CrazyHao1514/osd/1-5-OSD_Ⅰ_V3屏幕驱动及资料/pin脚图.jpg

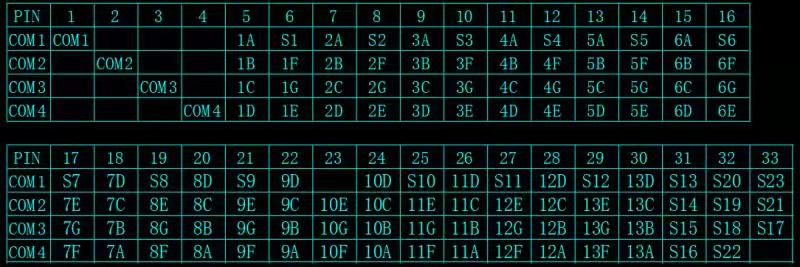
1-5-OSD_Ⅰ_V3屏幕驱动及资料/pin脚图.jpg
