CrazyHao1514/osd/文书/content.md

# 绪论
## 背景和意义
## 国内外发展现状
## 本文主要内容
# 环境监测系统设计
## 温度采集原理
## K型热电偶分析
## 环境监测系统设计框图
# 系统的硬件设计
## 温度传感器选择
## 信号调理模块设计
## A/D采样模块设计
## 核心处理器设计
## 电源转换模块选择
## 通信模块设计
## PCB抗干扰电路
# 系统的软件设计
## 自定义通信协议
## 下位机设计
## 上位机设计
# 测试与分析
## 硬件测试
## 软件测试
# 总结与展望
