CrazyHao1514/osd/3-1-OSD_I_V3 PCB图纸/华秋_1-2-OSD_Ⅰ_V3PCB设计图纸.pdf

auditwidget [Top Paste] Ratio:92.71% 周三 8月 14 12:19:01 2024 层数：4 尺寸：95.50*76.00 mm

a

u

ditwid
g

et [T
o

p

Silk] R
atio:9
2.71%

周
三

8

月 14 12:19:01 2
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
auditwidget [Top Solder] Ratio:92.71% 周三 8月 14 12:19:01 2024 auditwidget [Top Copper] Ratio:92.71% 周三 8月 14 12:19:01 2024

a

u

ditwid
g

et [In
n

er2] R

atio:9
2.71%

周
三

8

月 14 12:19:01 2
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
auditwidget [Inner3] Ratio:92.71% 周三 8月 14 12:19:02 2024 auditwidget [Bot Copper] Ratio:92.71% 周三 8月 14 12:19:02 2024 auditwidget [Bot Solder] Ratio:92.71% 周三 8月 14 12:19:02 2024

a

u

ditwid
g

et [B

ot Silk] R
atio:9
2.71%

周
三

8

月 14 12:19:0
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
auditwidget [Bot Paste] Ratio:92.71% 周三 8月 14 12:19:02 2024 auditwidget [Drl] Ratio:92.71% 周三 8月 14 12:19:02 2024 auditwidget [Outline] Ratio:92.71% 周三 8月 14 12:19:02 2024

a

u

ditwid
g

et [Drl Dra
w] R

atio:9
2.71%

周
三

8

月 14 12:19:0
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
auditwidget [2DLine.pho] Ratio:92.71% 周三 8月 14 12:19:02 2024
