CrazyHao1514/osd/文书/theory.md

# 基于NB-IoT的环境监测系统设计
# 1绪论
## 1.1背景和意义
21世纪，伴随医疗技术的突飞猛进，疾病治疗的空间尺度也在不断地缩小。当治疗技术深入到人体最基本的单位——细胞的层面时，便可以从根源上为患者解除病痛，达成更为彻底的治疗效果，因此细胞治疗成为了异于传统药物治疗和手术治疗的新热点。细胞治疗，指将（深）低温保存的人体健康细胞通过移植或是静脉注射的方式实现更新，进而促进人体重建组织的这一种治疗方法。这一技术的出现，为恶性肿瘤、原发性高血压、阿尔兹海默症等多种难以治愈的疾病提供了新的技术可能。

细胞存储作为细胞治疗技术产业链的上游基础，其供给的细胞质量高低，关系细胞治疗技术的发展。目前，广泛使用的生物细胞保存技术是超低温细胞冷冻存储技术。它是在低温（77K）条件下，通过抑制细胞生命活动，从而达到长期存储的目的，并且在解冻后仍能使得细胞保持生理活性的一种技术。

低温具有两面性，它既可以让生物样品处于低代谢状态，长期存储并保持活性，又能够在保存的过程中损伤细胞。在低温保存的过程中，样品的损伤主要来源自溶质损伤和机械损伤：
1) 溶质损伤。溶质损伤是由于温度曲线下降过慢导致的，此时水发生凝固，胞间游离的金属离子浓度突变增大；对于蛋白质等生物大分子而言，空间结构可能会被破坏，造成变性，引发功能不可逆损伤。
2) 机械损伤。机械损伤通常由冰晶生长的机械力引起。冰晶在细胞内和溶质中均存在，并且冰晶的体积与细胞存活率呈负相关。

上述两种冷冻损伤与温度梯度变化率关系密切，冰晶的形成和溶质浓度的改变亦受降温速度影响，是优化（深）低温保存的重要方向。
## 1.2国内外发展现状
### 1.2.1自动化样本库系统
国际上在近十几年内开展了一系列生物样本低温环境自动化存储的的研究和实践。以Biolix STC(Li CONi C,列支敦士登)193K自动化智能存储系统为例,其展示了自动化样本库系统的基本架构,组成的硬件包括热交换区、输送机械臂、程控降温仪(冰箱或液氮罐),均接受样本管理软件传达的指令。
### 1.2.2玻璃化保存技术
对于RNA、组织等珍贵样品，玻璃化保存则更为普遍，这要求环境温度低于137K；玻璃化保存时生化反应都趋近于停止。上海理工大学已经在生物样本的深低温存储方面积累了雄厚的理论基础，主要包括：置核-程序降温热控制方法，低温保护剂的热物性，生物体低温保存过程热分析。
## 1.3目前存在的问题
1) 现有玻璃化保存技术逐渐普及，但大多数程控降温设备的温度监测范围仍局限在223K至193K之间，无法覆盖玻璃化保存所需的137K以下的温度范围。
2) 市场上出现了以机械臂为核心的自动化样本处理设备，极大地降低了操作人员发生冻伤的风险。然而，目前多数此类设备依赖进口，采购成本高昂。
3) 虽然现有的样本库系统具备与计算机的通信功能，但数据主要在本地进行处理和存储，不利于样本信息的共享，也缺乏便捷的远程报警机制。
## 1.4本课题主要工作
本课题针对当前生物样本库在温度监测领域的现状，提出了一种基于窄带物联网（NB-IoT）的温度监测系统，旨在提升深低温保存技术的应用效果及系统的整体智能化水平。具体内容如下：
1) 应用温度检测范围下限低于137K的温度传感器，适配玻璃化保存技术。
2) 提供多种常见通信接口，以提高系统的兼容性和扩展性，避免样本中心重新采购昂贵设备的必要。
3) 引入窄带物联网技术和云数据托管平台，实现对温度异常等事件的主动上报，并支持通过短信推送提醒功能。
# 2系统方案设计
## 2.1温度采集原理
在计算机发明之前，人类主要依赖度量衡工具和自身感官来获取被测物体的各类信息，随后使用纸笔记录数据。然而，随着科学研究的深入以及工业生产需求的增加，数据处理的复杂性和精确度要求逐渐提高，传统的手动数据采集和记录方式显然已无法满足这些需求。

为了克服传统数据采集和记录方法的局限性，计算机和传感器应运而生。计算机作为一种用于高速运算的电子设备，能够自动化地处理大量数据，从而显著提升了人类的计算能力。然而，计算机只能处理二进制形式的电信号，而现实中大多数信号为非电量信号。因此，如果仍采用人工方式将这些信号输入计算机，数据处理的效率将大大降低。这就需要引入传感器技术。传感器是一种检测装置，能够感知被测物体的物理量信息，并将这些信息按照特定规律转换成电信号或其他所需形式（如频率或脉冲信号）。通过传感器，非电量信号被转换为电信号，再经过模数转换器将这些电信号（模拟信号）转换为数字信号（如二进制数），从而实现与计算机的有效连接与数据处理。

温度传感器是传感器技术中的重要组成部分，主要分为接触式和非接触式两大类。接触式温度传感器包括热电偶和热敏电阻，这些传感器需与被测物体直接接触；而非接触式温度传感器则通过检测物体所产生的热辐射来测量温度。
1) 热电偶是一种基于塞贝克效应的温度传感器，利用两种不同金属在接合点处的温差产生电压来测量温度。1821年，德国科学家塞贝克发现，当两种不同金属连接成回路，并在两端接点处施加不同温度时，回路中会产生电流，称为热电流，而产生的电势则称为热电势。热电偶由两个不同的导体或半导体材料构成闭合回路，当两接点（测量端与冷端）存在温差时，回路中产生的热电势与温差成正比。通过测量热电势，可以确定测量端的温度。
2) 热敏电阻
热敏电阻由半导体材料构成，其电阻率对温度变化极为敏感。根据电阻率随温度变化的不同特性，热敏电阻可分为正温度系数（PTC）热敏电阻和负温度系数（NTC）热敏电阻。PTC热敏电阻的电阻值会随温度升高而增加；相反，NTC热敏电阻的电阻值会随温度升高而降低。热敏电阻的特性常用Steinhart-Hart方程来表征，该方程将热敏电阻的电阻值转换为开尔文温度值。
3) 电阻式温度检测器（RTD）
电阻式温度检测器（RTD）是一种基于金属电阻随温度变化而改变的特性来测量温度的传感器。RTD的工作原理是利用导体或半导体的热阻效应，即电阻值随温度变化而变化，通过测量其电阻值来推算温度。常用的RTD材料为铂（如Pt100），因其具有优良的稳定性和易于获取的优点。
4) 红外线温度传感器
红外线温度传感器（或称辐射温度计）的原理是通过透镜将物体发射的0.7 µm至20 µm波长的红外线聚焦到热电堆检测元件上。热电堆是一种能够吸收红外线并产生与温度相对应电信号的检测元件。该电信号经过放大和发射率补偿后，显示物体的温度。
## 2.2热电偶分析
塞贝克效应表明，由两种导体A和B再两端焊接构成的闭合回路，当其两接点保持某一温度差时，回路中将有电流流过。此回路称为热电回路，其中出现的电流称为热电流。在热电回路中存在一种电动势，称为热电动势$E_{AB}$，通常称为温差电动势。回路中的热电源$I$的大小决定于热电动势和回路中的电阻。

现在将回路断开，如图所示，图中导体A、B分别称为热电极A和热电极B。我们假设用$E_A$和电阻$R_A$来代表热电极A，用$E_B$和$R_B$来代表热电极B。如图就是用电位差计测量$V_{ab}$的等效电路。当达到平衡时$I=0$,此时有
$$\Delta V=E_{ab}=E_B-E_A \tag{1}$$
$(1)$式表明，用电位差计测得的电压降$\Delta V_{ab}$就是热电回路$(AB)$中的热电动势$E_{AB}$。由$(1)$式可知，此时热电回路中的热电动势$E_{AB}$与回路中电阻无关，仅与热电回路两接点间的温度差$\Delta T=T_2-T_1$有关。定义$\Delta V_{ab}$对$\Delta T$的微分热电动势为热电回路的热电势率，用$S_{AB}$表示，有
$$S_{AB}=\lim_{\Delta T \to 0}\frac{\Delta V_{ab}}{\Delta T}=\frac{dV_{ab}}{dT} \tag{2}$$
$S_{AB}$也称为塞贝克系数，从$(2)$式可以看出它代表该热电回路的灵敏度。考虑到$(1)$式，$(2)$式也可以写为
$$S_{AB}=\lim_{\Delta T \to 0}\frac{E_B}{\Delta T}-\lim_{\Delta T \to 0}\frac{E_A}{\Delta T}=S_B-S_A \tag{3}$$
式中$S_A$和$S_B$分别为热电极A、B的绝对热电势率。可见，某热电回路$(AB)$的塞贝克系数$S_{AB}$的正负和大小仅决定于构成此热电回路的两个热电极的绝对热电势差之差。

如果某热电回路的$S_{AB}$是已知的，则该回路的热电动势$E_{AB}$可由$(2)$式积分求得：
$$E_{AB}=\int_{T_0}^T{S_{AB}(T)}{\rm d}T \tag{4}$$
考虑到$(3)$式，上式又可表为
$$E_{AB}=\int_{T_0}^T[S_B(T)-S_A(T)]{\rm d}T \tag{5}$$
如果在有限温度范围内$(S_B-S_A)$基本恒定不变，则$(5)$式可表示为
$$E_{AB}=(S_B-S_A)\Delta T \tag{6}$$
式中$\Delta T=T_2-T_1$，表示热电回路两接点间的温度差。在实践中要应用$(6)$式来求某热电回路的热电动势值，必须假设两种热电极才是A、B的热电性是均匀的，两种热电极材料的绝对热电势差之差$(S_B-S_A)$与温度无关。这样，如果将热电回路中的一个接点保持在某一个恒定不变的温度（例如冰点）$T_0$时，则$E_{AB}$便仅随另一个接点的温度$T$而变化。也就是说，此时$E_{AB}$仅仅是温度$T$的单值函数。这样，我们可以利用这种$E_{AB}$与$T$的一一对应的关系来测量温度。

不同金属配对就构成不同的热电偶。每种热电偶的$E-T$特性常用表格、曲线的关系表示。在实验室中精确测定热电偶的$E-T$特性的程序称为分度，由此而得到的$E-T$对用表称为该种热电偶的分度表。

热电偶的两个热电极在测量端相互连接，在参考端分别与铜导线连接，铜导线的另一端分别与电测仪表的正、负接线柱连接。如图所示的就是热电偶测温的基本热电回路。
## 2.3环境监测系统设计框图
# 3系统的硬件设计
## 3.1温度传感器选择
## 3.2信号调理模块设计
## 3.3A/D采样模块设计
## 3.4核心处理器设计
## 3.5电源转换模块选择
## 3.6通信模块设计
## 3.7PCB抗干扰电路
# 4系统的软件设计
## 4.1自定义通信协议
## 4.2下位机设计
## 4.3上位机设计
# 5测试与分析
## 5.1硬件测试
## 5.2软件测试
# 6总结与展望
