CrazyHao1514/osd/文书/intro.md

# 基于NB-IoT的环境监测系统设计
# 1绪论
## 1.1背景和意义
21世纪，伴随医疗技术的突飞猛进，疾病治疗的空间尺度也在不断地缩小。当治疗技术深入到人体最基本的单位——细胞的层面时，便可以从根源上为患者解除病痛，达成更为彻底的治疗效果，因此细胞治疗成为了异于传统药物治疗和手术治疗的新热点。细胞治疗，指将（深）低温保存的人体健康细胞通过移植或是静脉注射的方式实现更新，进而促进人体重建组织的这一种治疗方法。这一技术的出现，为恶性肿瘤、原发性高血压、阿尔兹海默症等多种难以治愈的疾病提供了新的技术可能。

细胞存储作为细胞治疗技术产业链的上游基础，其供给的细胞质量高低，关系细胞治疗技术的发展。目前，广泛使用的生物细胞保存技术是超低温细胞冷冻存储技术。它是在低温（77K）条件下，通过抑制细胞生命活动，从而达到长期存储的目的，并且在解冻后仍能使得细胞保持生理活性的一种技术。

低温具有两面性，它既可以让生物样品处于低代谢状态，长期存储并保持活性，又能够在保存的过程中损伤细胞。在低温保存的过程中，样品的损伤主要来源自溶质损伤和机械损伤： <br/>
1) 溶质损伤。溶质损伤是由于温度曲线下降过慢导致的，此时水发生凝固，胞间游离的金属离子浓度突变增大；对于蛋白质等生物大分子而言，空间结构可能会被破坏，造成变性，引发功能不可逆损伤。<br/>
2) 机械损伤。机械损伤通常由冰晶生长的机械力引起。冰晶在细胞内和溶质中均存在，并且冰晶的体积与细胞存活率呈负相关。

上述两种冷冻损伤与温度梯度变化率关系密切，冰晶的形成和溶质浓度的改变亦受降温速度影响，是优化（深）低温保存的重要方向。
## 1.2国内外发展现状
### 1.2.1自动化样本库系统
国际上在近十几年内开展了一系列生物样本低温环境自动化存储的的研究和实践。以Biolix STC(Li CONi C,列支敦士登)193K自动化智能存储系统为例,其展示了自动化样本库系统的基本架构,组成的硬件包括热交换区、输送机械臂、程控降温仪(冰箱或液氮罐),均接受样本管理软件传达的指令。
### 1.2.2玻璃化保存技术
对于RNA、组织等珍贵样品，玻璃化保存则更为普遍，这要求环境温度低于137K；玻璃化保存时生化反应都趋近于停止。上海理工大学已经在生物样本的深低温存储方面积累了雄厚的理论基础，主要包括：置核-程序降温热控制方法，低温保护剂的热物性，生物体低温保存过程热分析。
## 1.3本课题主要工作
本课题针对当前生物样本库在温度监测领域的现状，提出了一种基于窄带物联网（NB-IoT）的温度监测系统，旨在提升深低温保存技术的应用效果及系统的整体智能化水平。具体内容如下：
1) 首先，现有玻璃化保存技术逐渐普及，但大多数程控降温设备的温度监测范围仍局限在-50至-80摄氏度之间，无法覆盖玻璃化保存所需的-136摄氏度以下的温度范围。为此，本文选用K型热电偶作为温度传感器，其低温探测能力优于传统设备，能够满足更为严苛的深低温保存需求。
2) 其次，随着自动化技术在生物工程领域的融合发展，市场上出现了以机械臂为核心的自动化样本处理设备，极大地降低了操作人员发生冻伤的风险。然而，目前多数此类设备依赖进口，采购成本高昂。本文设计的系统同时提供了USART和RS485两种常见通信接口，以提高系统的兼容性和扩展性，避免重新采购昂贵设备的必要。
3) 最后，虽然现有的样本库系统具备与计算机的通信功能，但数据主要在本地进行处理和存储，不利于样本信息的共享，也缺乏便捷的远程报警机制。本文引入窄带物联网技术和云数据托管平台，实现对温度异常等事件的主动上报，并支持通过短信推送提醒功能，降低了系统使用者的技术门槛，提升了系统的易用性和安全性。
# 2环境监测系统设计
## 2.1温度采集原理
## 2.2K型热电偶分析
## 2.3环境监测系统设计框图
# 3系统的硬件设计
## 3.1温度传感器选择
## 3.2信号调理模块设计
## 3.3A/D采样模块设计
## 3.4核心处理器设计
## 3.5电源转换模块选择
## 3.6通信模块设计
## 3.7PCB抗干扰电路
# 4系统的软件设计
## 4.1自定义通信协议
## 4.2下位机设计
## 4.3上位机设计
# 5测试与分析
## 5.1硬件测试
## 5.2软件测试
# 6总结与展望
