CrazyHao1514/osd/IMG/2108.jpg

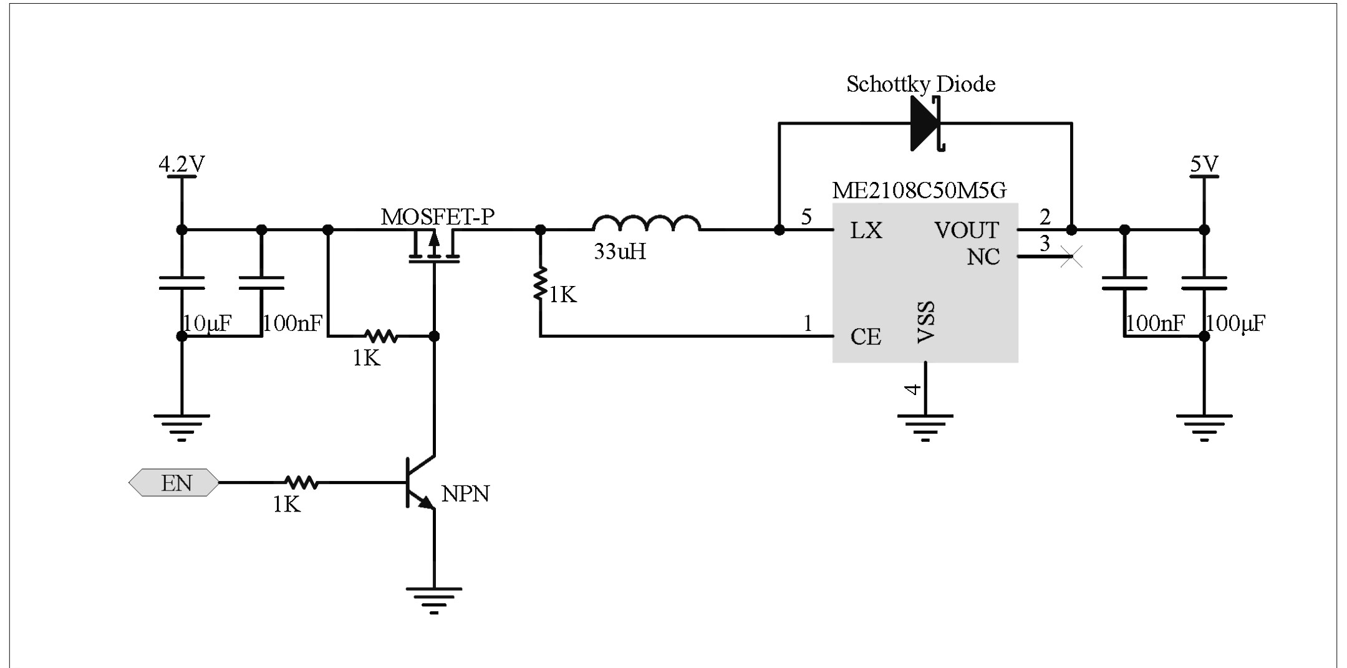
IMG/2108.jpg
