CrazyHao1514/osd/IMG/3085.jpg

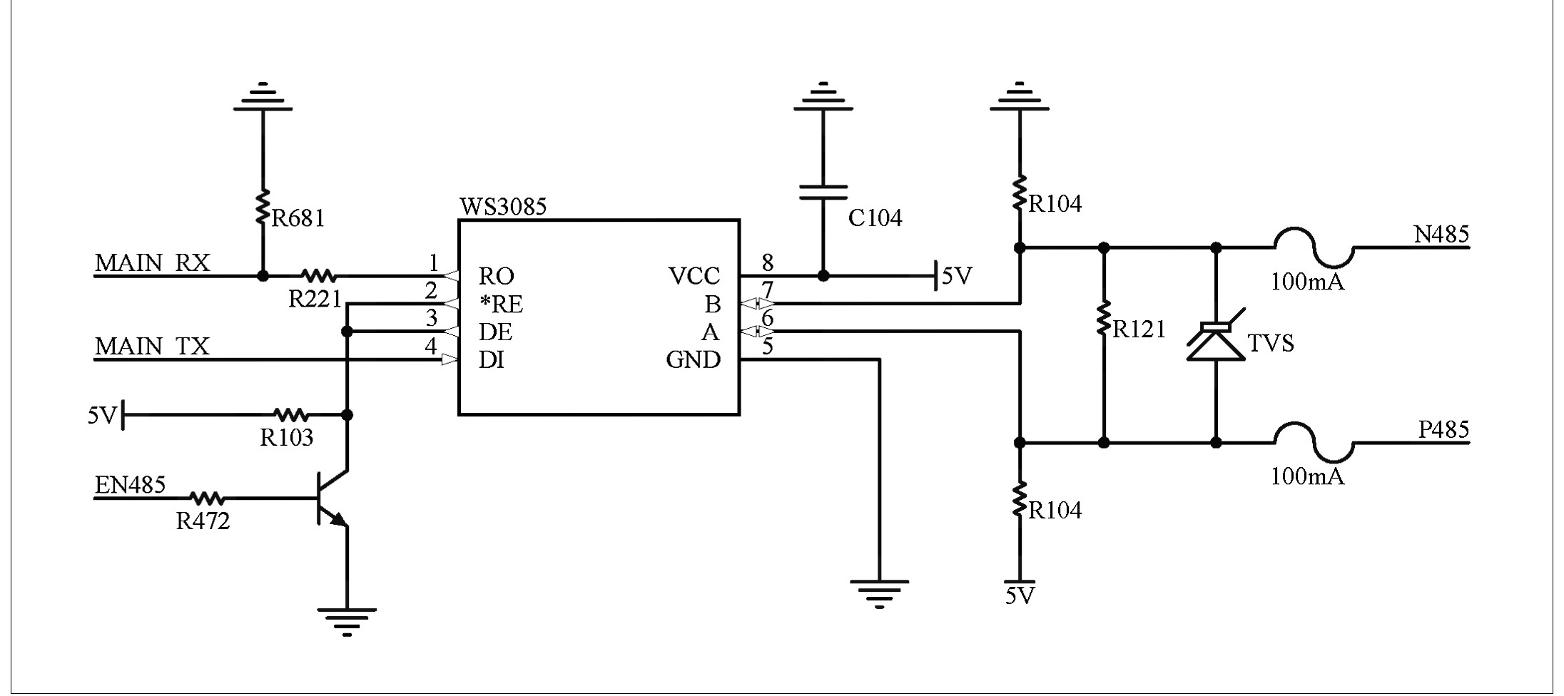
IMG/3085.jpg
