CrazyHao1514/osd/IMG/4054.jpg

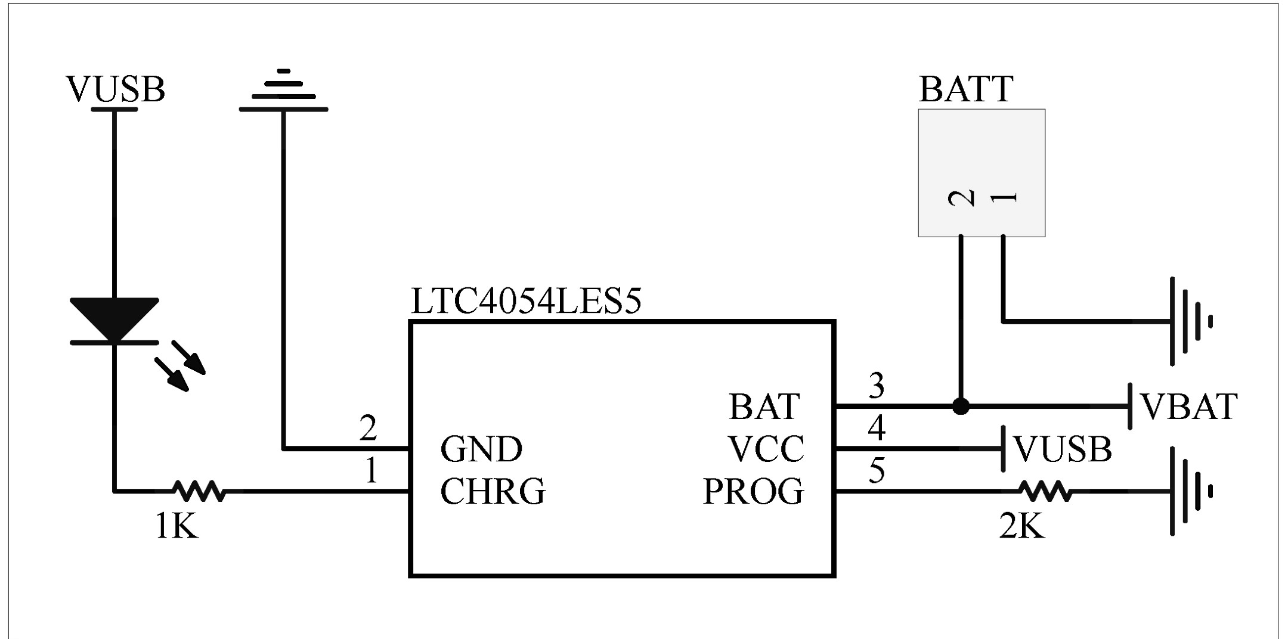
IMG/4054.jpg
