CrazyHao1514/osd/IMG/6220.jpg

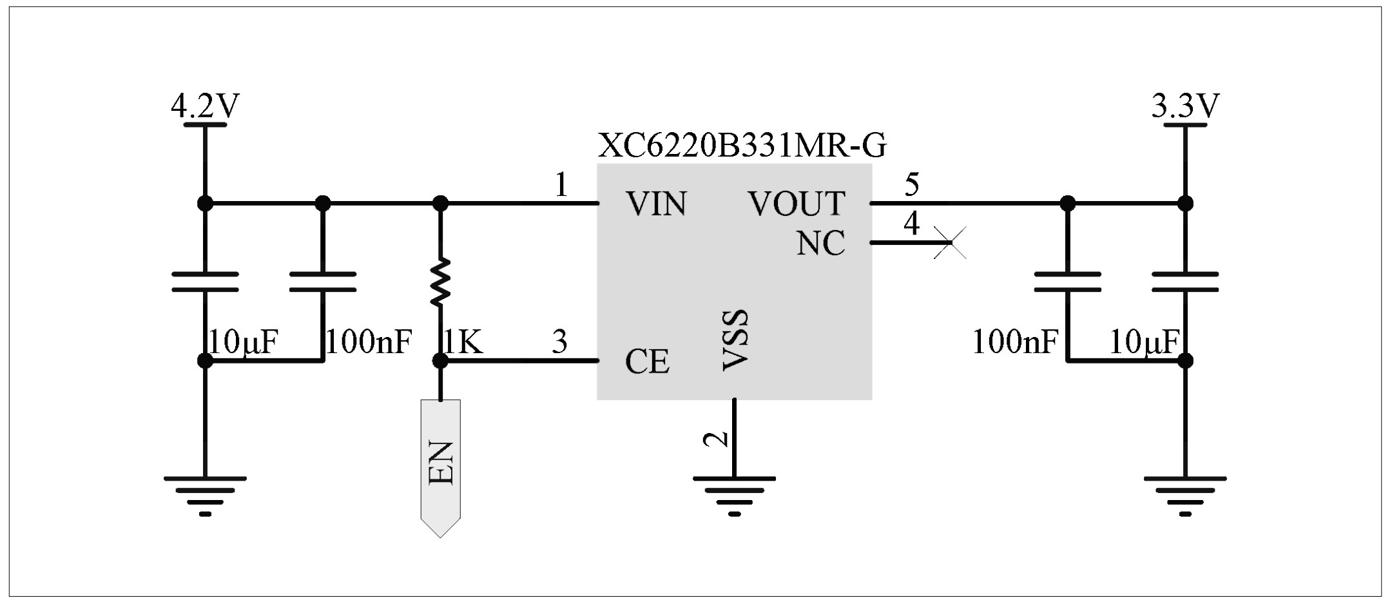
IMG/6220.jpg
