CrazyHao1514/osd/IMG/6220_CL.jpg

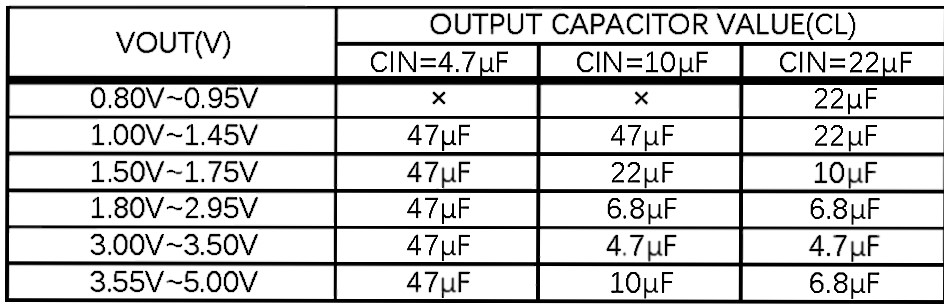
IMG/6220_CL.jpg
