CrazyHao1514/osd/IMG/29302.png

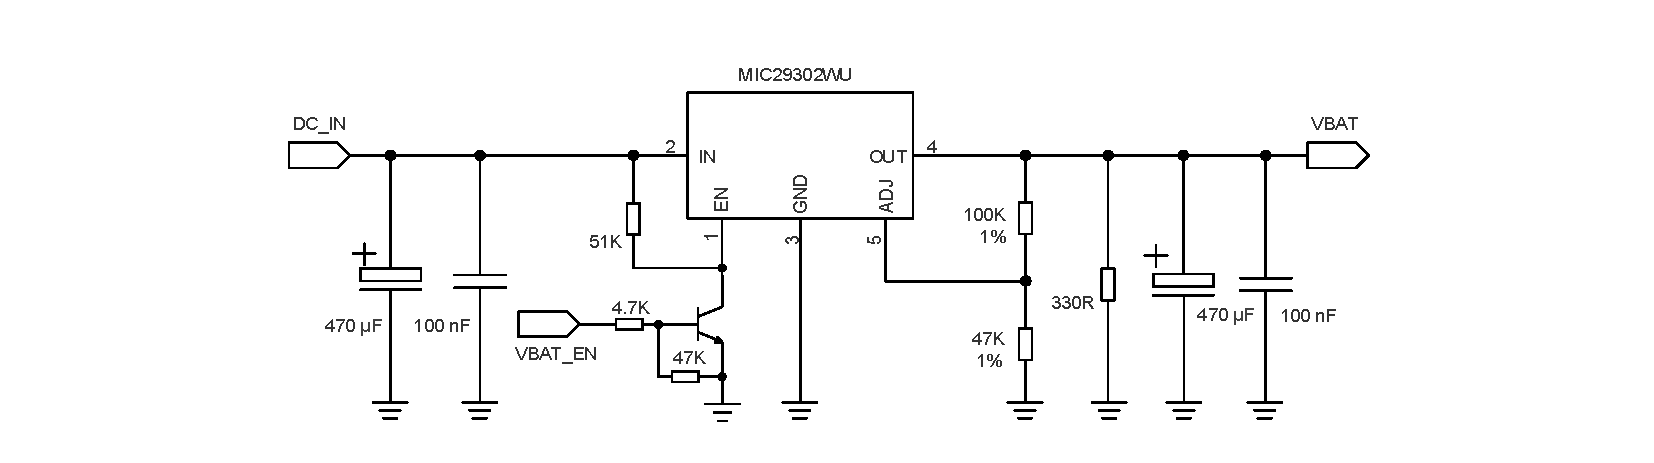
IMG/29302.png
