CrazyHao1514/osd/IMG/adc.jpg

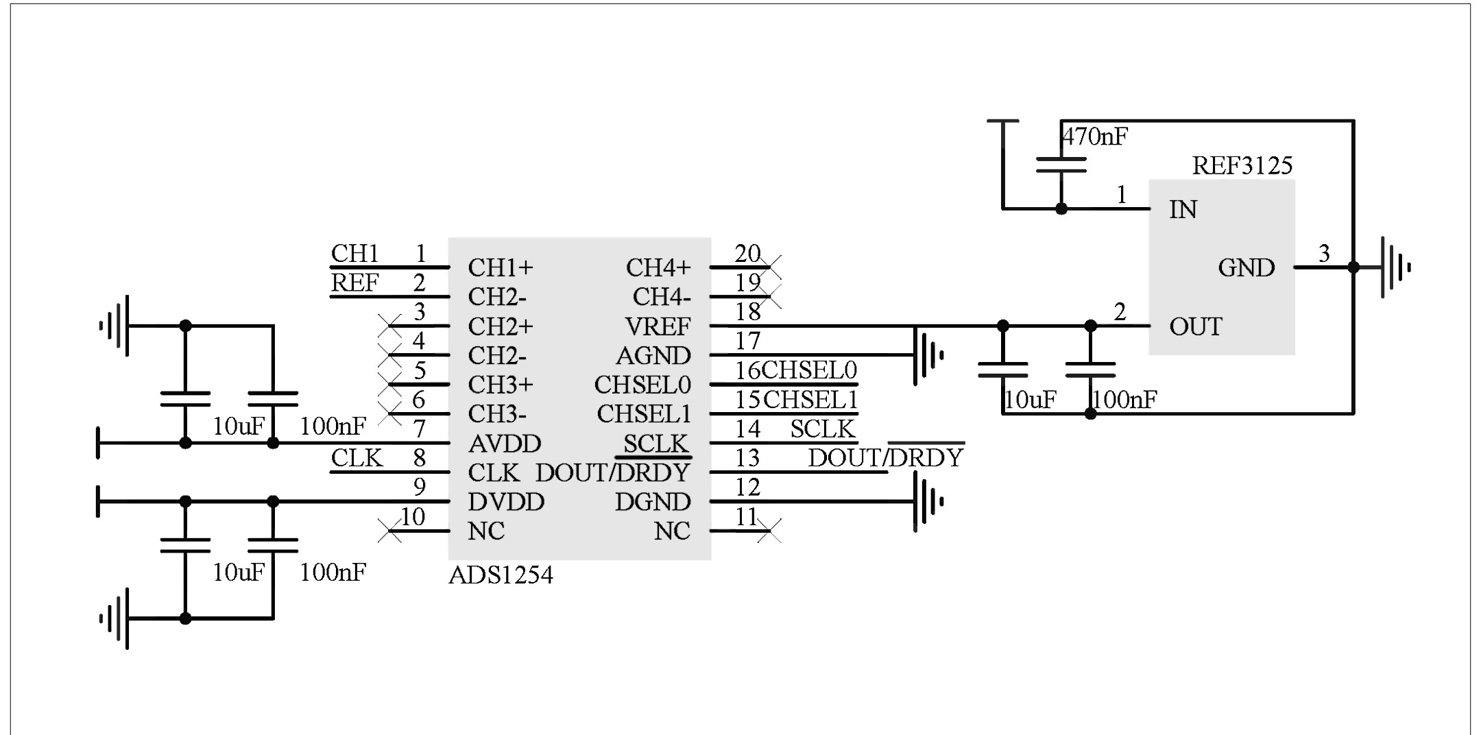
IMG/adc.jpg
