CrazyHao1514/osd/IMG/amp.jpg

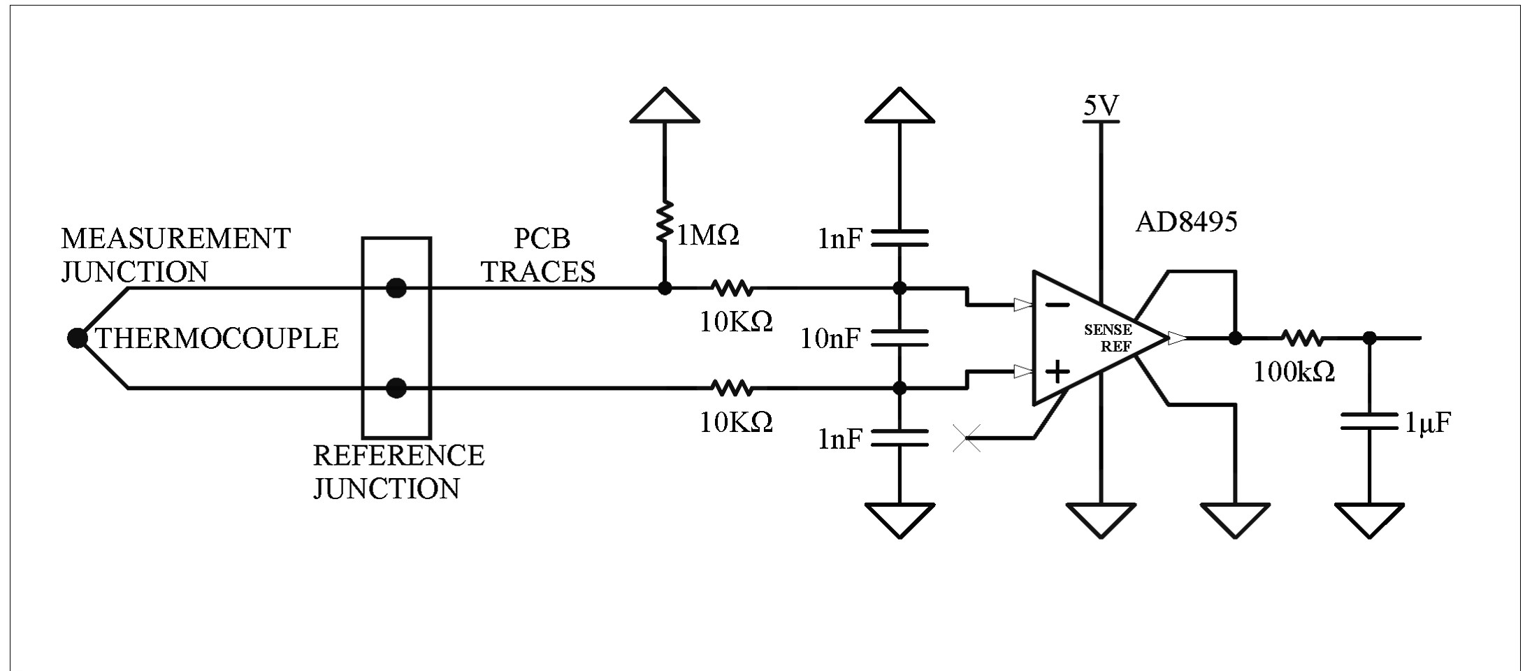
IMG/amp.jpg
