CrazyHao1514/osd/IMG/ant8266.png

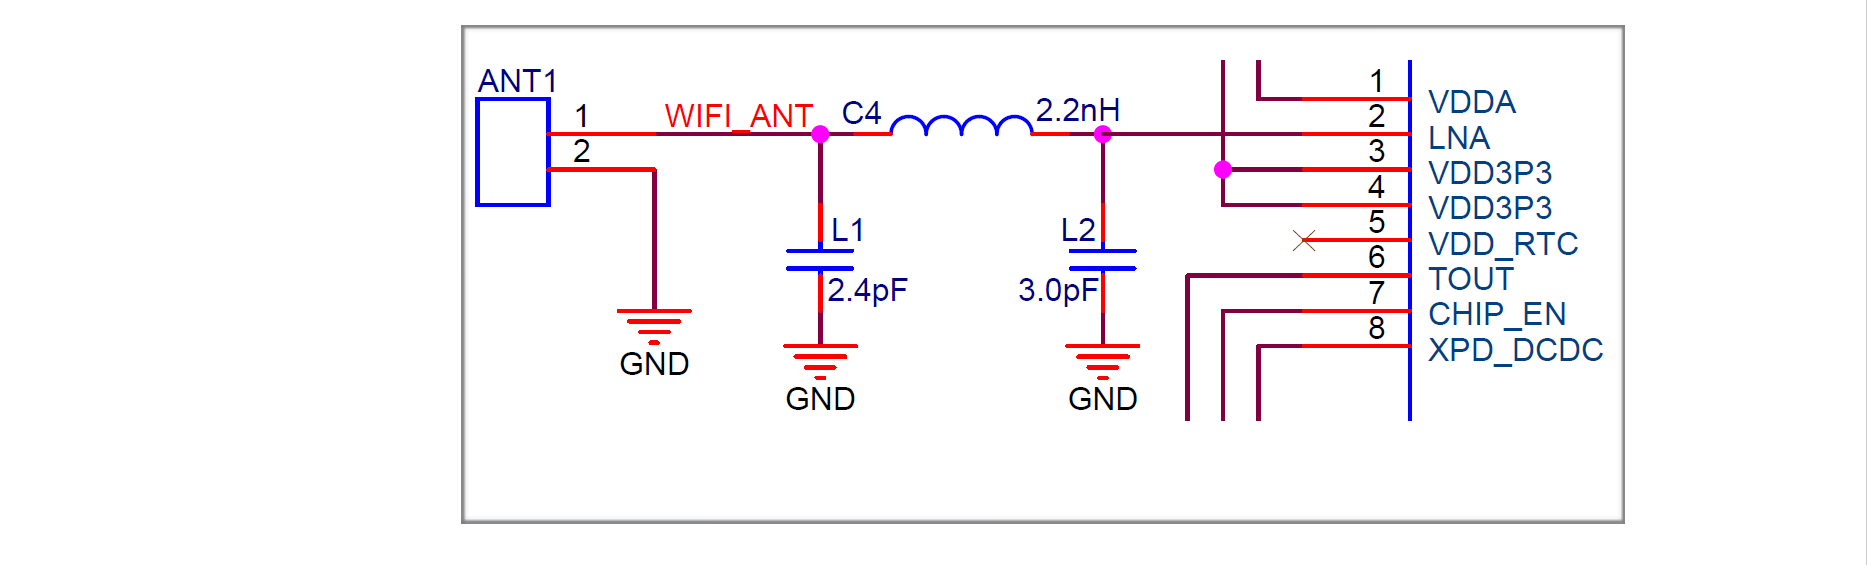
IMG/ant8266.png
