CrazyHao1514/osd/IMG/ant.png

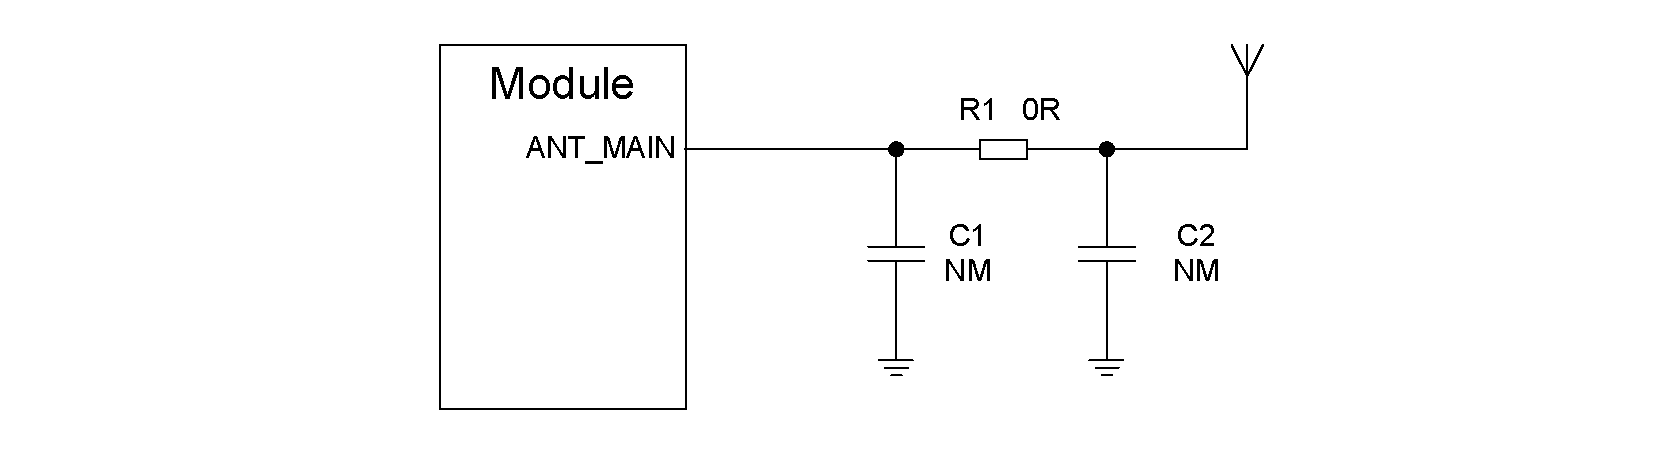
IMG/ant.png
