CrazyHao1514/osd/IMG/CH376.jpg

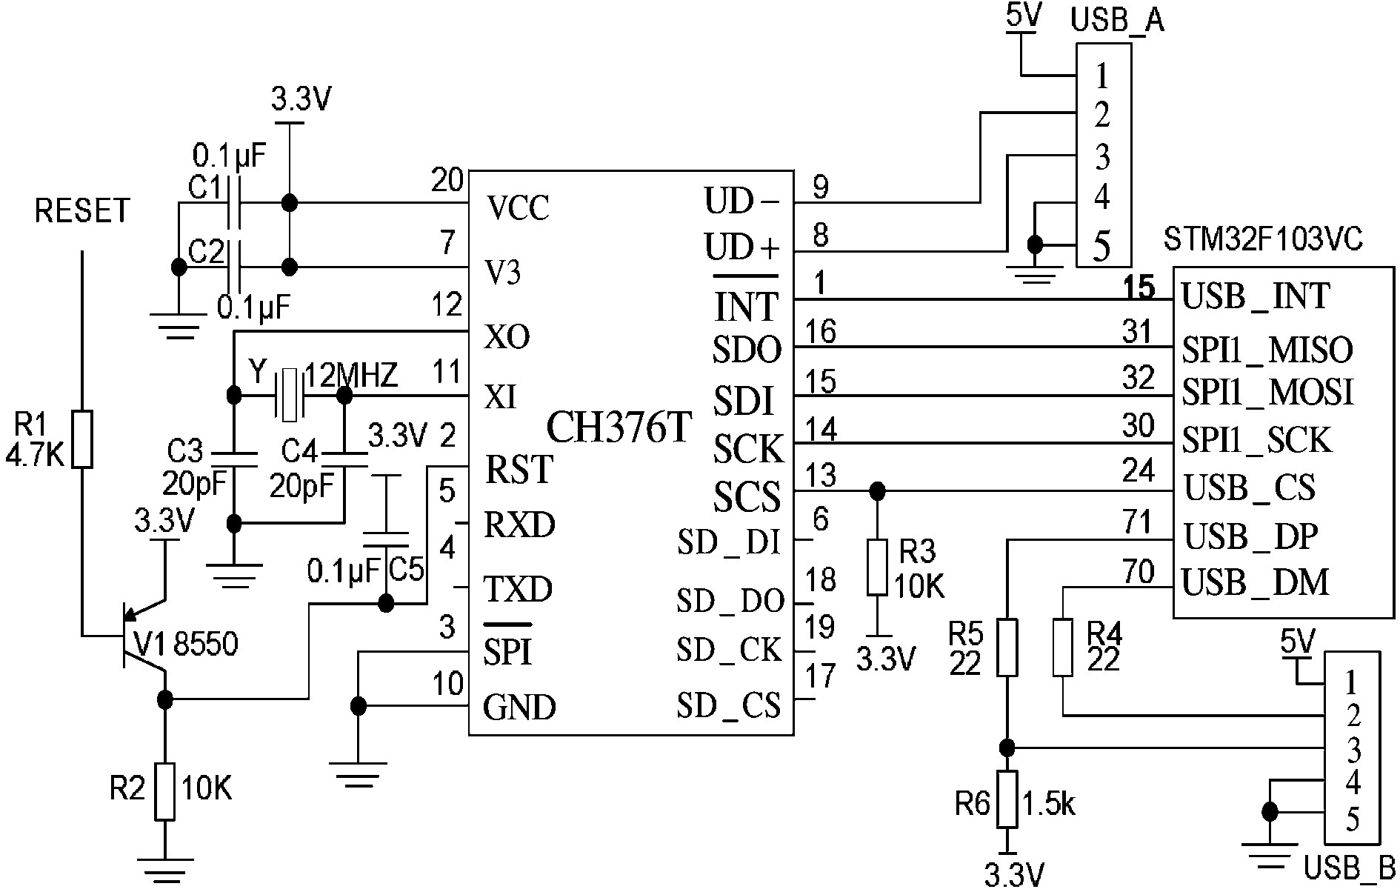
IMG/CH376.jpg
