CrazyHao1514/osd/IMG/get1.png

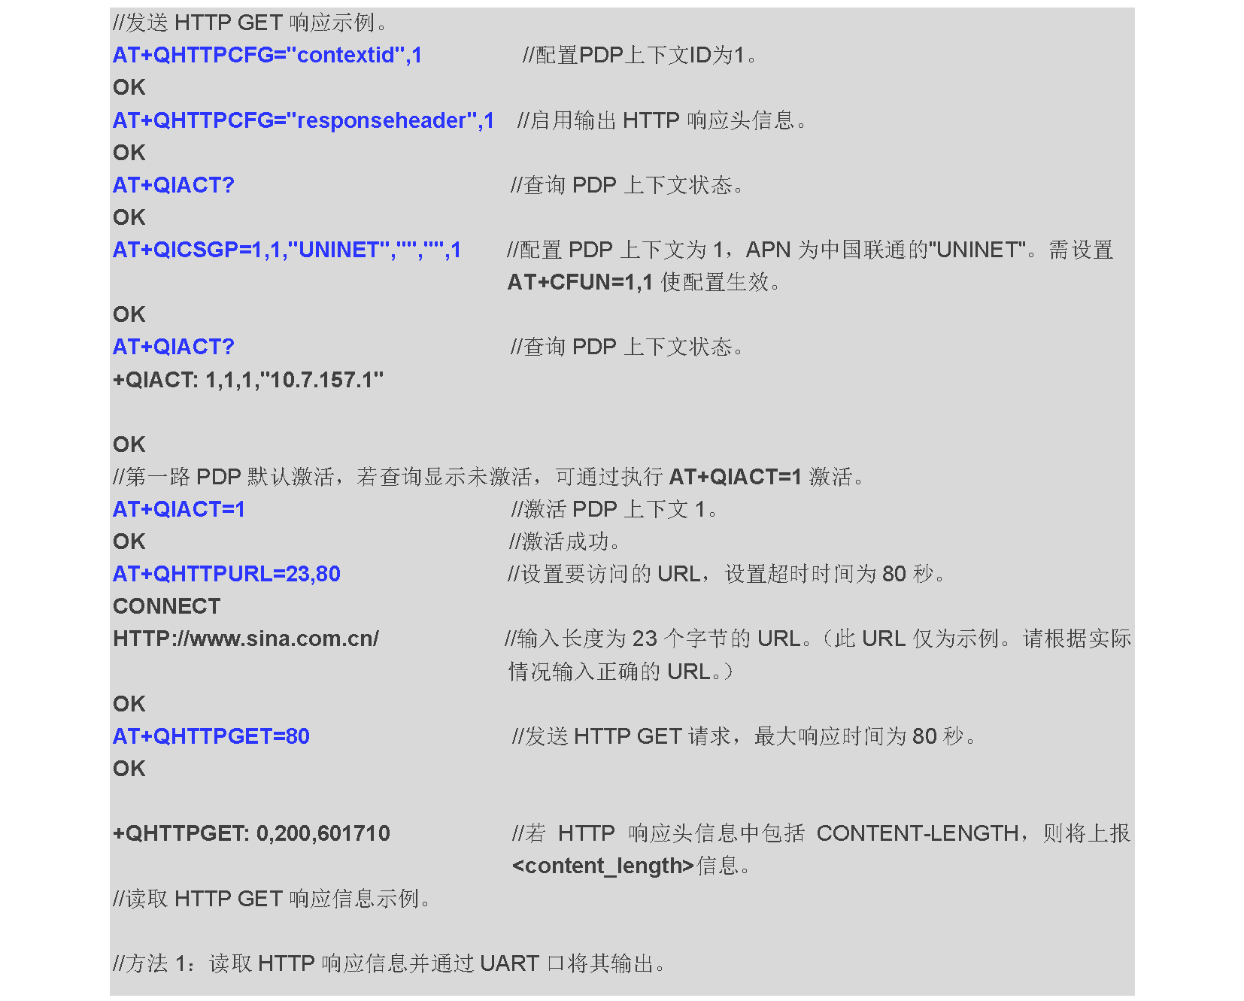
IMG/get1.png
