CrazyHao1514/osd/IMG/get2.png

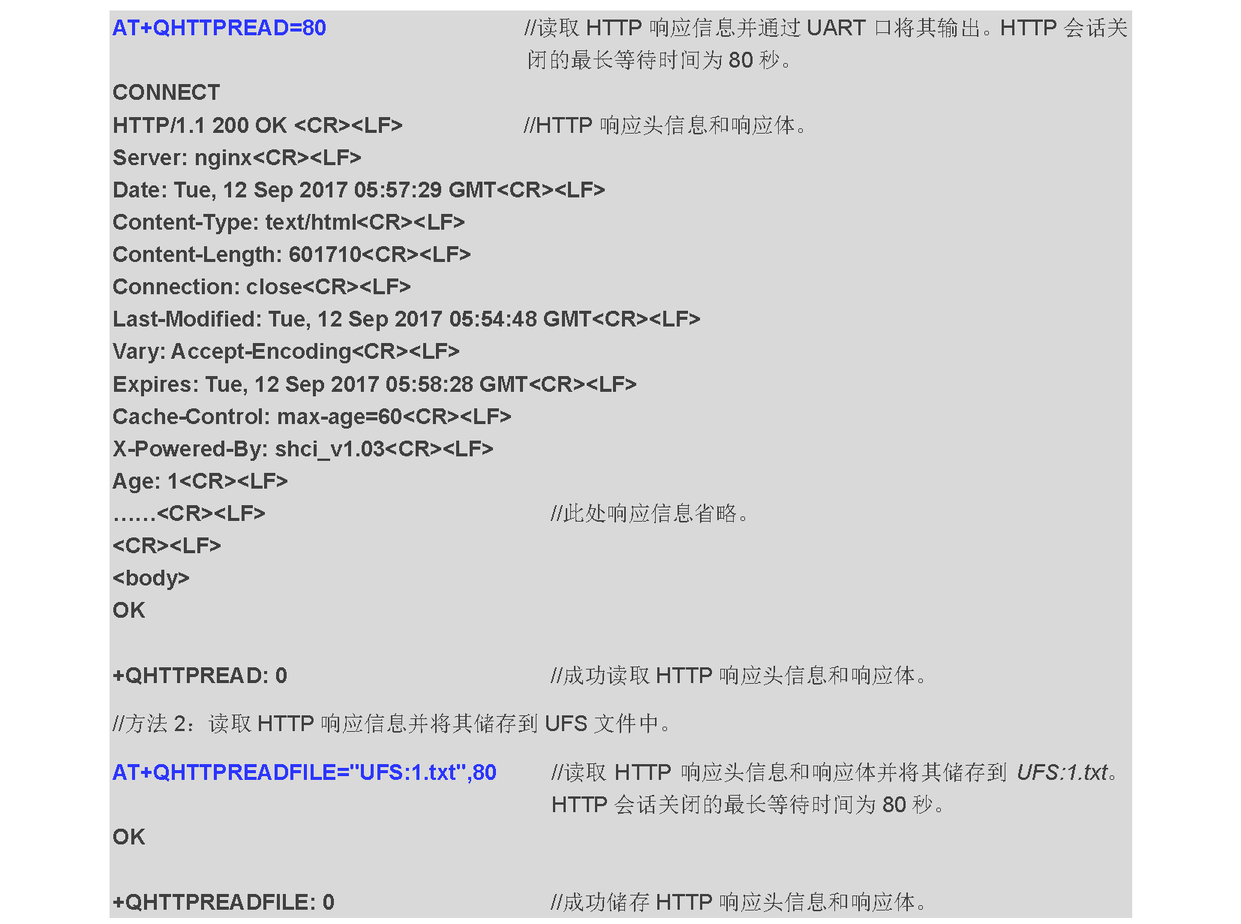
IMG/get2.png
