CrazyHao1514/osd/IMG/key.png

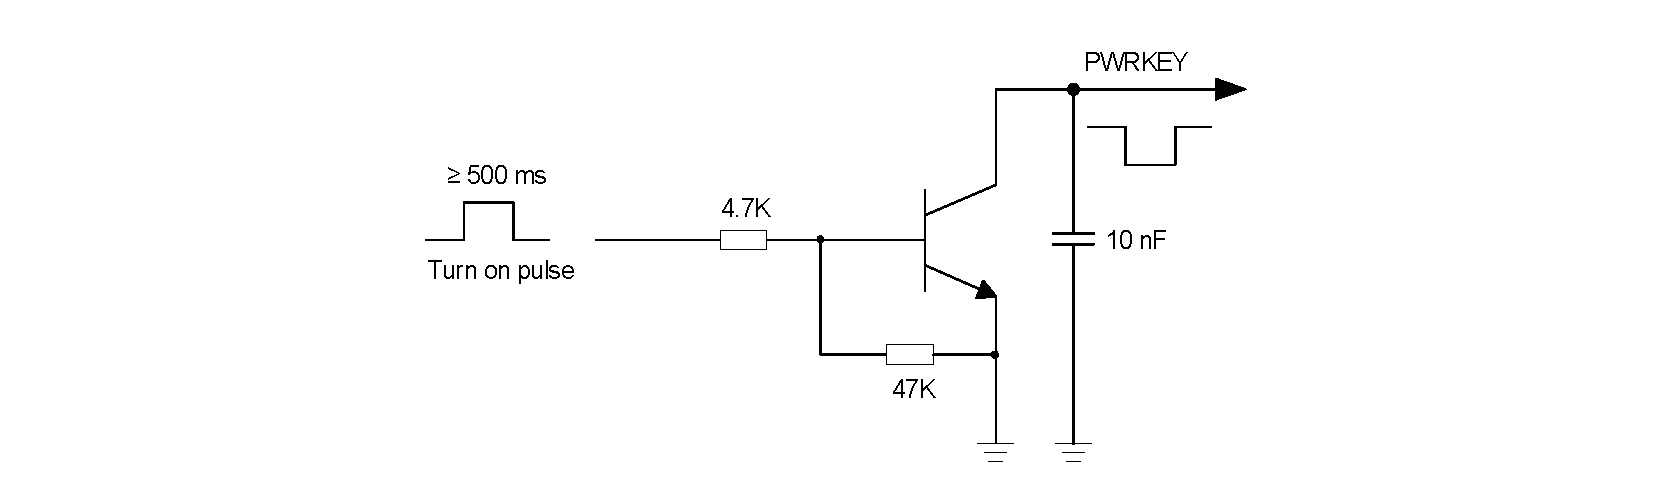
IMG/key.png
