CrazyHao1514/osd/IMG/low.png

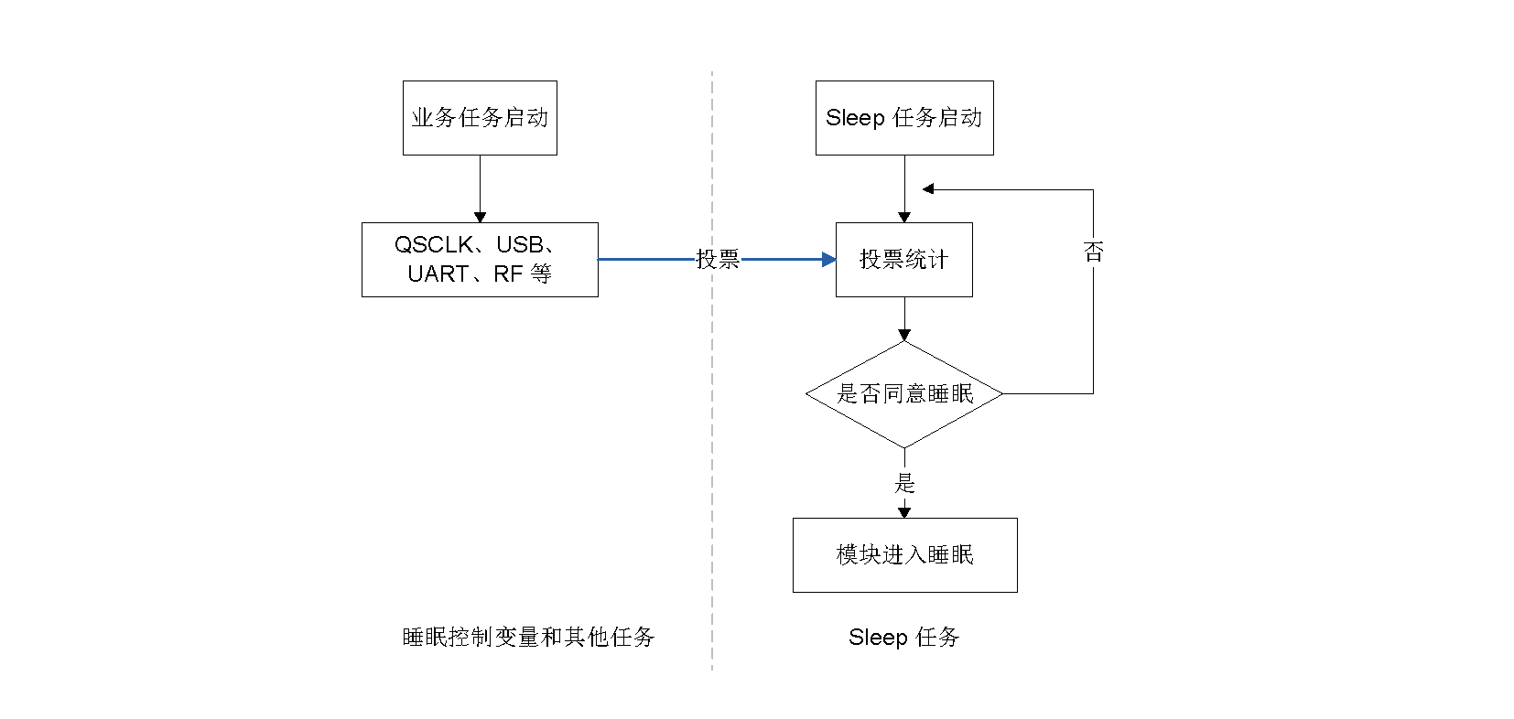
IMG/low.png
