CrazyHao1514/osd/IMG/osc.png

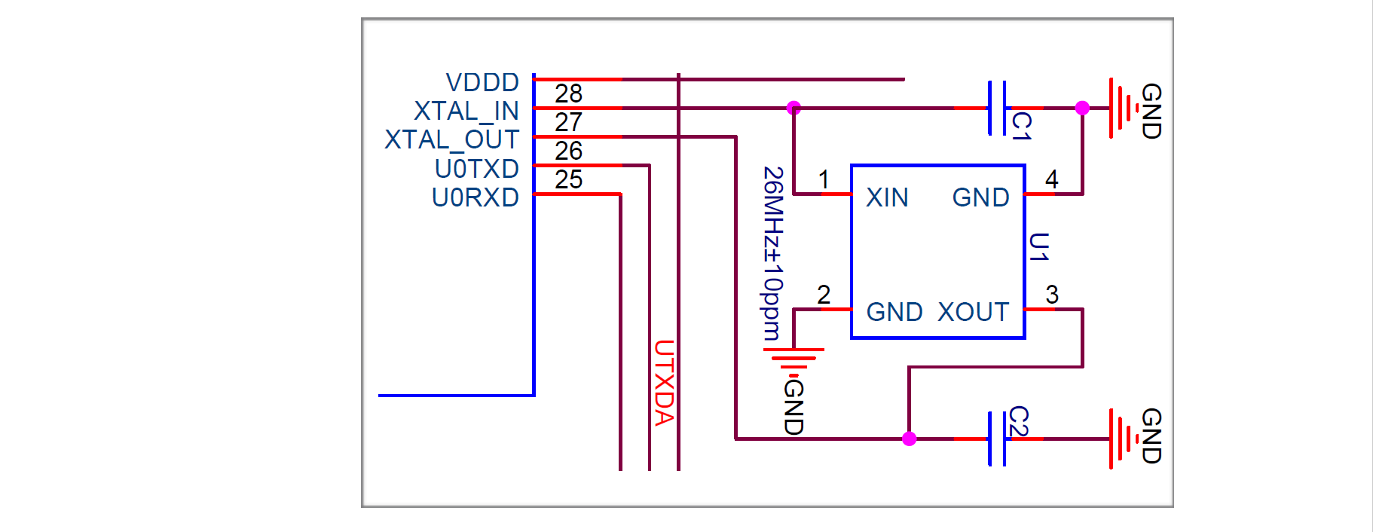
IMG/osc.png
