CrazyHao1514/osd/IMG/post1.png

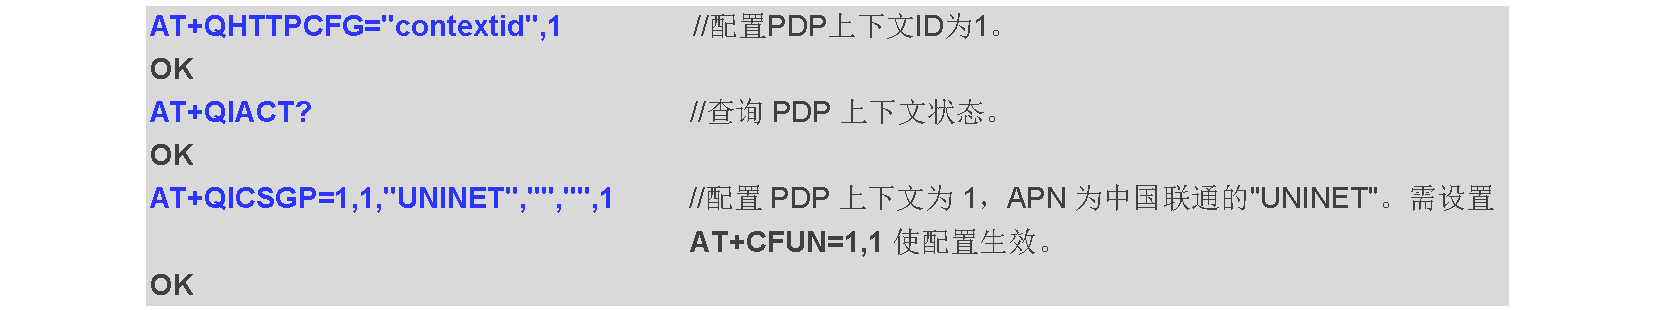
IMG/post1.png
