CrazyHao1514/osd/IMG/pwr8266.png

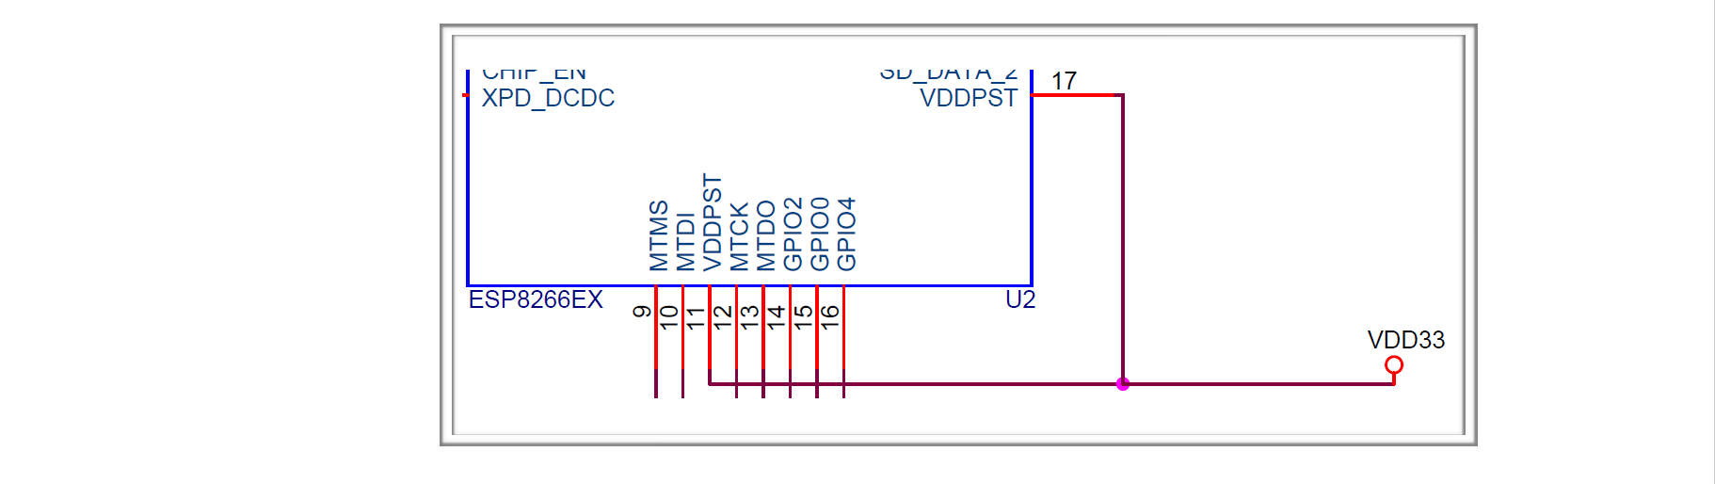
IMG/pwr8266.png
