CrazyHao1514/osd/IMG/pwr.png

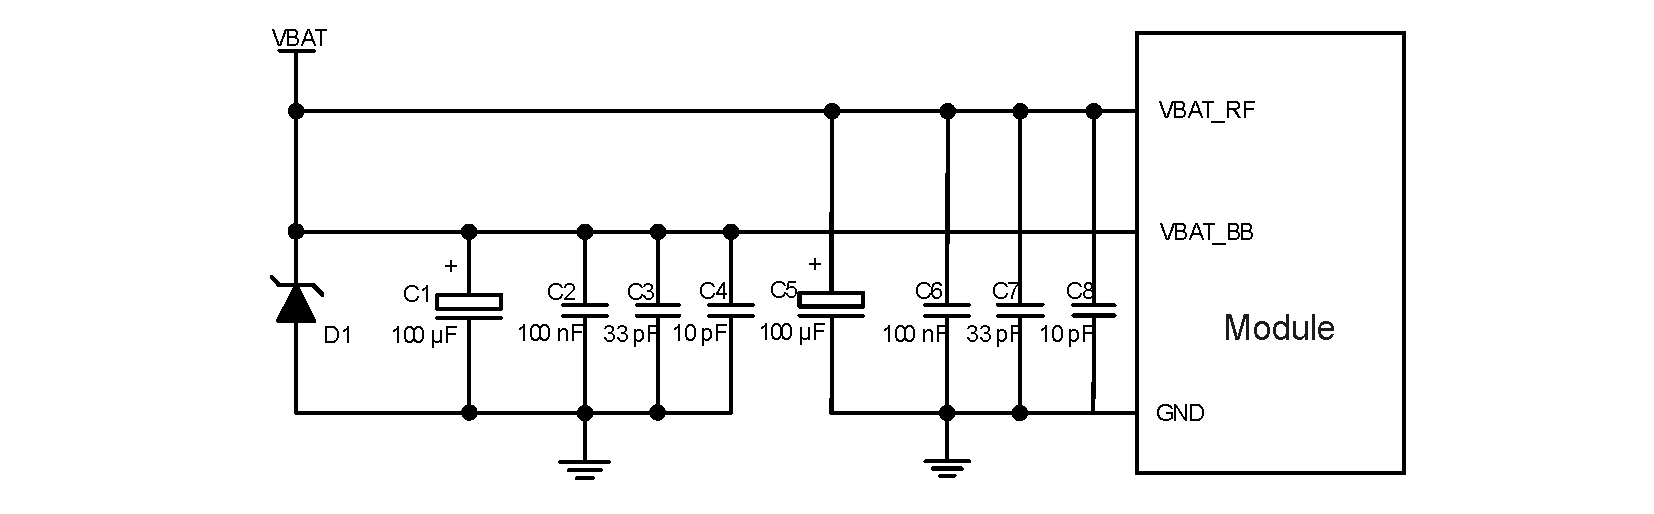
IMG/pwr.png
