CrazyHao1514/osd/IMG/sim.png

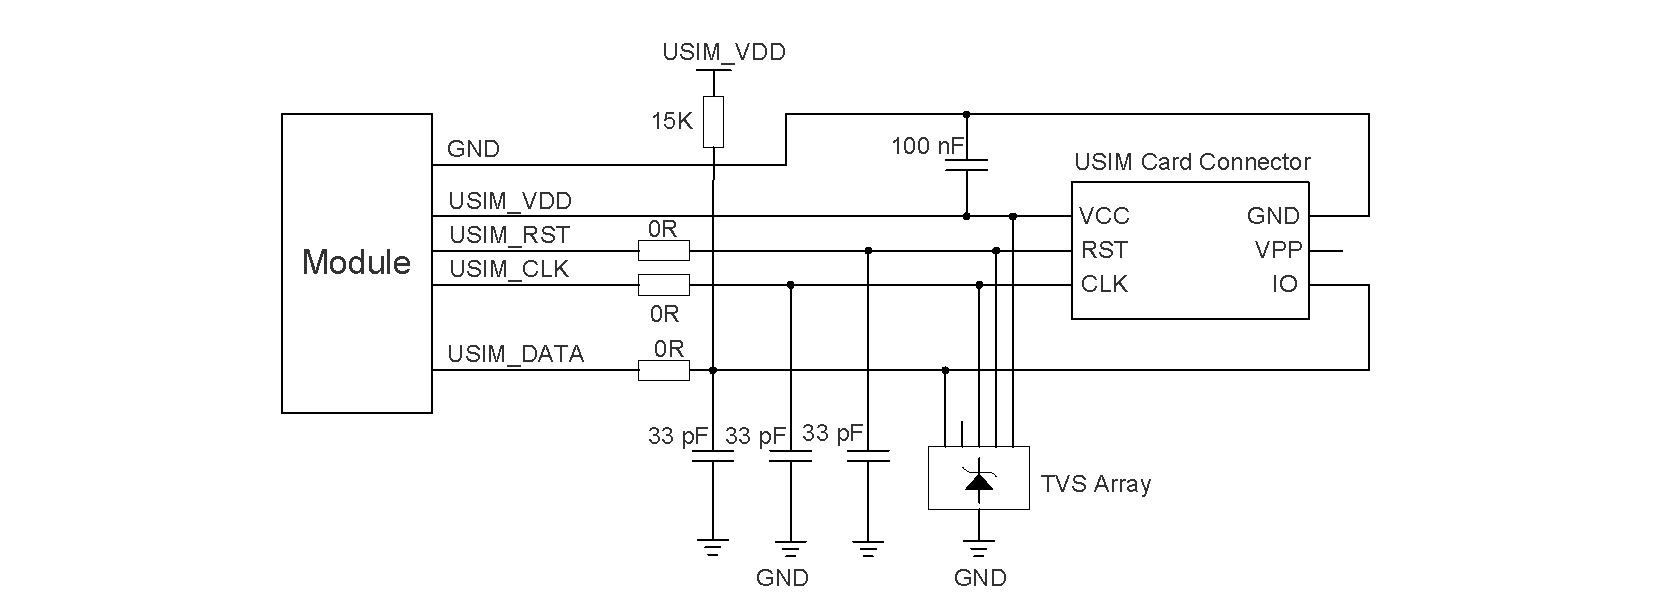
IMG/sim.png
