CrazyHao1514/osd/IMG/uart8266.png

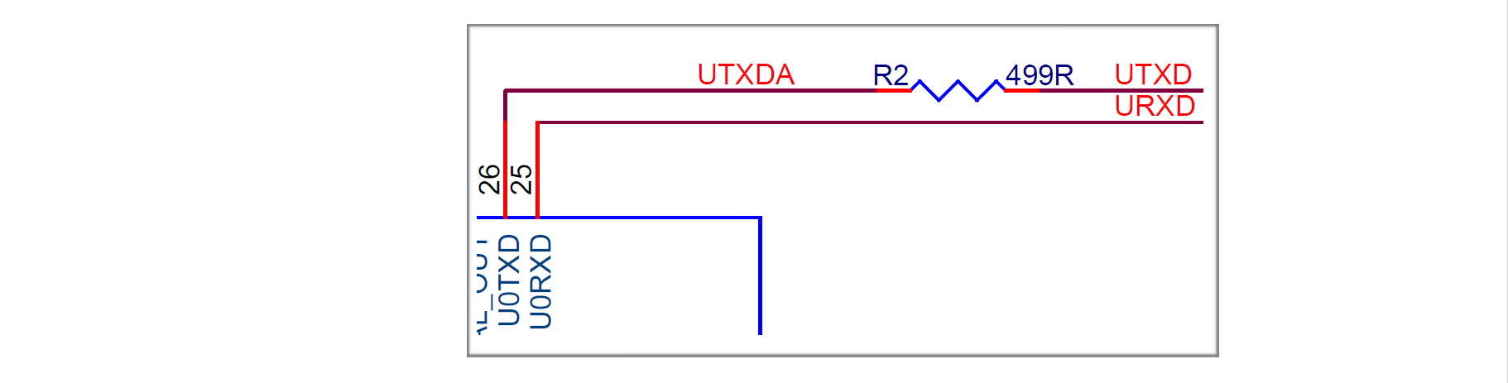
IMG/uart8266.png
