CrazyHao1514/osd/IMG/vol.png

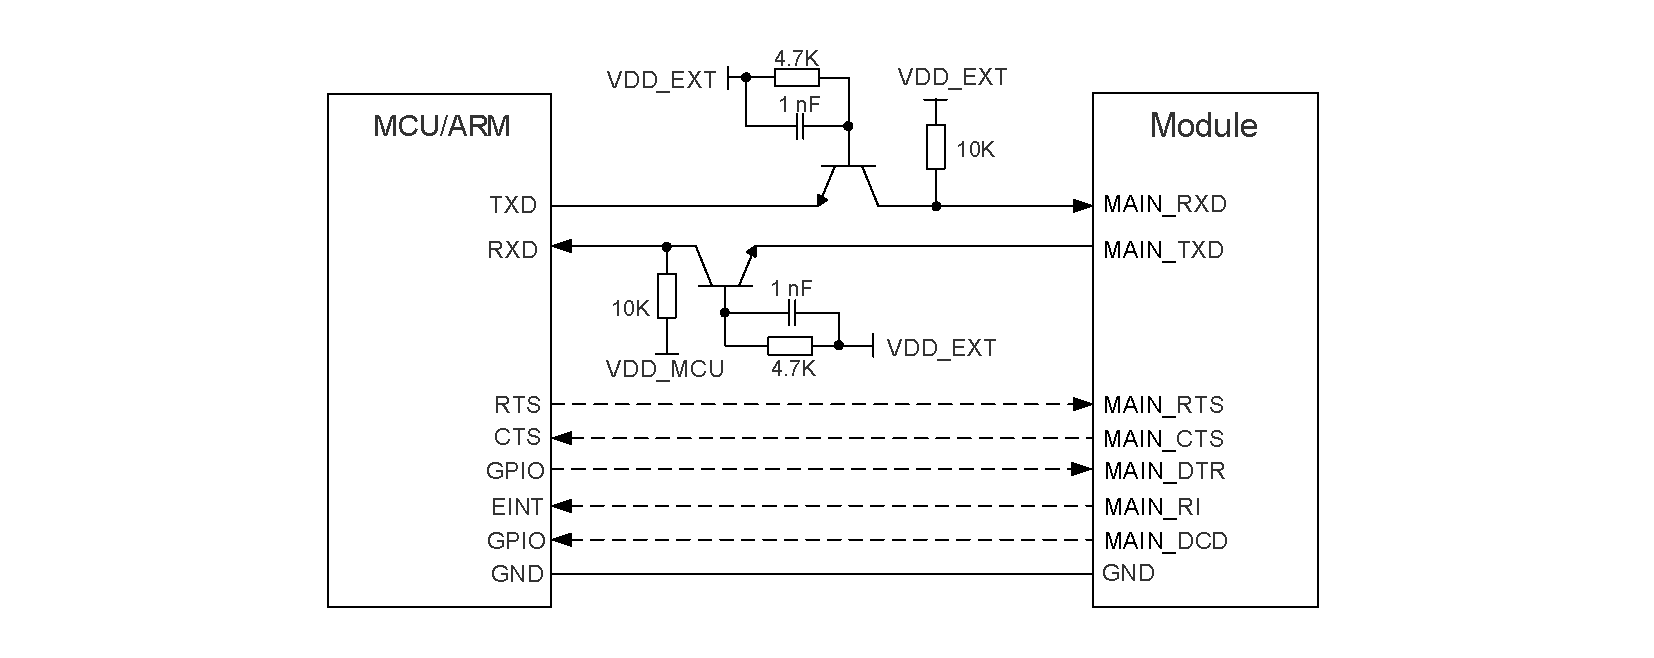
IMG/vol.png
