CrazyHao1514/osd/BOM清单/2-1-OSD_Ⅰ_V3BOM清单.xlsx

编制：Lydia |  |  | 审核：宋倩倩 | 批准：Paul |  |  | 发布日期：2021-09-03
BOM编号：OSD_V3_20210903 |  |  |  | 项目编号： |  |  | 工艺要求：无铅
产品名称：智能环境监测仪OSD-Ⅰ |  |  |  | 贴片数量： |  |  | PCB版本：RevB
Item | Level | QTY | RFC | Part name/Description | Commodity Code | MFR | 备注
1 |  | 1 | C16 | CAP1210-47UF10%10V | LMK325B7476KM-T | TAIYO YUDEN(太诱)
2 |  | 2 | C31 C110 | CAP1206-100uf | JMK316BJ107ML-T | TAIYO YUDEN(太诱)
3 |  | 2 | C12 C15 | CAP0805-22UF10%10V | C2012X5R1A226KT000N | TDK
4 |  | 13 | C3 C5 C11 C13-14 C19-20 C24-26 C29 C32 C37 | CAP0603-10uF,+/-5% | CL10A106MP8NNNC | SAMSUNG(三星)
5 |  | 1 | C38 | CAP0402-1UF,10%50V, | 0402X105K6R3CT | 华新科(Walsin)
6 |  | 2 | C1-2 | CAP0402-100NF+10%50V,NC |  |  | NC
7 |  | 29 | C4 C6-10 C17-18 C21-23 C27-28 C30 C34-36 C39 C47 C50-53 C55-57 C61-63 | CAP0402-100NF+10%50V | 0402B104K500CT | 华新科(Walsin)
8 |  | 1 | C33 | CAP0402-1NF+10%50V | 0402B102J500CT | 华新科(Walsin)
9 |  | 2 | C42-43 | CAP0402-22PF+10%50V | CC0402GRNPO9BN220 | YAGEO(国巨)
10 |  | 1 | R3 | RES1206,0R | RC1206JR-070RL | YAGEO(国巨)
11 |  | 1 | R28 | RES0603,100R,+/-5% | RC0603JR-07100RL | YAGEO(国巨)
12 |  | 11 | R16-20 R34 R36 R52 R54 R63-64 | RC0402-100K1%,100K1% | RC0402JR-07100KL | YAGEO(国巨)
13 |  | 2 | R21-22 | RC0402-51K1%,51K1% | AC0402JR-0751KL | YAGEO(国巨)
14 |  | 4 | R46-47 R55 R57 | RC0402-12K1%,12K1% | AC0402JR-0712KL | YAGEO(国巨)
15 |  | 22 | R11 R27 R35 R42-45 R68-73 R1 R56 R30-32 R94 R100 R105-106 | RC0402-10K1%,10K1% | RC0402JR-0710KL | YAGEO(国巨)
16 |  | 1 | R10 | RC0402-10K1%,5.1K | RC0402JR-075K1L | YAGEO(国巨)
17 |  | 1 | R97 | RC0402-4.7K1%,4.7K | RC0402JR-074K7L | YAGEO(国巨)
18 |  | 1 | R98 | RC0402-2K1%,2K | RC0402JR-072KL | YAGEO(国巨)
19 |  | 20 | R2 R8-9 R13-15 R26 R29 R33 R37 R85-87 R89-93 R12 R74 | RC0402-1K1%,1K | RC0402JR-071KL | YAGEO(国巨)
20 |  | 1 | R24 | RC0402-200R1%,200R1% | RC0402JR-07200RL | YAGEO(国巨)
21 |  | 2 | R51 R61 | RC0402-180R1%,180R1% | RC0402JR-07180RL | YAGEO(国巨)
22 |  | 2 | R53 R62 | RC0402-100R1%,100R1% | RC0402JR-07100RL | YAGEO(国巨)
23 |  | 6 | R4-7 R23 R25 | RC0402-22R1%, | RC0402FR-0722RL | YAGEO(国巨)
24 |  | 3 | R95 R99 R80 | RC0402-0R1%,0R | RC0402FR-070RL | YAGEO(国巨)
25 |  | 2 | L2-3 | 1206,IND-MOLDED,FB | CBW321609U221T | FH(风华)
26 |  | 1 | L4 | WPN4020-10UH,10UH | WPN4020H100MT | Sunlord(顺络)
27 |  | 6 | Q1 Q3-7 | DTC043，DTC143ZE | DTC143ZE | TC(德昌)
28 |  | 1 | Q10 | N-MOS-SOT-323，BSS123 | BSS123 | Slkor(萨科微)
29 |  | 3 | Q2 Q9 Q12 | P-MOS-SOT-23，AO3401A | AO3401-SOT23 | PUOLOP(迪浦)
30 |  | 2 | Q8 Q11 | S8050，NPN，BC847B | BC847B | Hottech(合科泰)
31 |  | 3 | D1-2 D10 | MBR0530-SOD-123 | MBR0530 | CJ（江苏长电/长晶）
32 |  | 1 | D26 | RED-LED-0805 | TJ-S2012SW8TGLC2R-A5 | TOGIALED(台湾统佳)
33 |  | 2 | TVS5-6 | TVS/SOD923/ON,PESD1CAN |  |  | NC
34 |  | 2 | J1 J4 | 3.5EARPHONE | PJ-320B贴片 | BOOMELE(博穆精密)
35 |  | 3 | J2 J5 J8 | USB-MACRO | KH-MICRO6.4H-5P | kinghelm(金航标)
36 |  | 1 | J6 | 15050064-CONS3-WIFIANT-3MM-ECT818000071,天线座 | SP-RF-001 | XUNPU(讯普)
37 |  | 1 | U4 | 2.54X4P | WAFER-254W-4P | XUNPU(讯普)
38 |  | 1 | J | 2.54X2P | WAFER-254W-2P | XUNPU(讯普)
39 |  | 1 | J3 | 2P-8MM,背光板 |  |  | 厂供
40 |  | 3 | S1-3 | KEY_4,PWRKEY | GT-TC084E-H020-L5 | G-Switch(品赞)
41 |  | 1 | U1 | EC600N-CN | EC600NCNLA-N05-SNNSA | QUECTEL
42 |  | 1 | U10 | TLV2252 | TLV2252IDR | TI(德州仪器)
43 |  | 1 | U11 | 9325-4531电子开关芯片 | 9325-4531 | ELITECHIP
44 |  | 1 | U12 | CH376T，USB芯片 | CH376T | WCH(南京沁恒)
45 |  | 1 | U13 | TFPUSH-SMD | XKTF-015-N | XKB Connectivity(中国星坤)
46 |  | 1 | U14 | RGB3528 | HL-AF-3528S39FU70GH203BC-A-S1-HL | HONGLITRONIC(鸿利光电)
47 |  | 1 | U15 | MIC29302-TO-263-5 | MIC29302AWU-TR | MICROCHIP(美国微芯)
48 |  | 1 | U16 | ESP-12E，ESP-12S | ESP-12S | Ai-Thinker(安信可)
49 |  | 1 | U17 | SEGLED |  |  | NC
50 |  | 1 | U18 | SSOP48,HT1621 | HT1621 | HGSEMI(华冠)
51 |  | 1 | U19 | SP485-SOP8_S | WS3085EESA-GEC | GEC(南京国博)
52 |  | 1 | U2 | SIM-114 | SMN-305 | XUNPU(讯普)
53 |  | 1 | U3 | STM32F407VET6-LQFP-100 | STM32F407VET6 | ST(意法半导体)
54 |  | 1 | U5 | DCDC-LTC4054,SOT-23-5 | LTC4054ES5-4.2#PBF | ADI(亚德诺)/LINEAR
55 |  | 3 | U6-8 | DCDC-XC6220 | XC6220B331MR-G | TOREX(特瑞仕)
56 |  | 1 | U9 | DCDC-ME2108,SOT-23-5 | ME2108C30M5G | MICRONE(南京微盟)
57 |  | 1 | Y1 | GT-11P,AXIS-200-R4蜂鸣器 | FMB1265-03 | FUET(福声科技)
58 |  | 1 | Y3 | Y25M-SMD-5032_2P,25M,晶振 | X503225MSB2GI | YXC扬兴科技
59 |  | 1 | Y8 | Y12M-SMD-5032_2P,12M，晶振 | SMD-5032_2P 12M 20pf 30p | TAE(雅晶鑫)
60 |  | 1 | Z3 | TL431-SOT-23,0.5V | TL431 | SMSEMI(杰盛微)
