CrazyHao1514/osd/3-1-OSD_I_V3 PCB图纸/1-1-OSD_Ⅰ_V3电路设计原理图.pdf

D

6 | 5 | 4 | 3 | 2 | 1

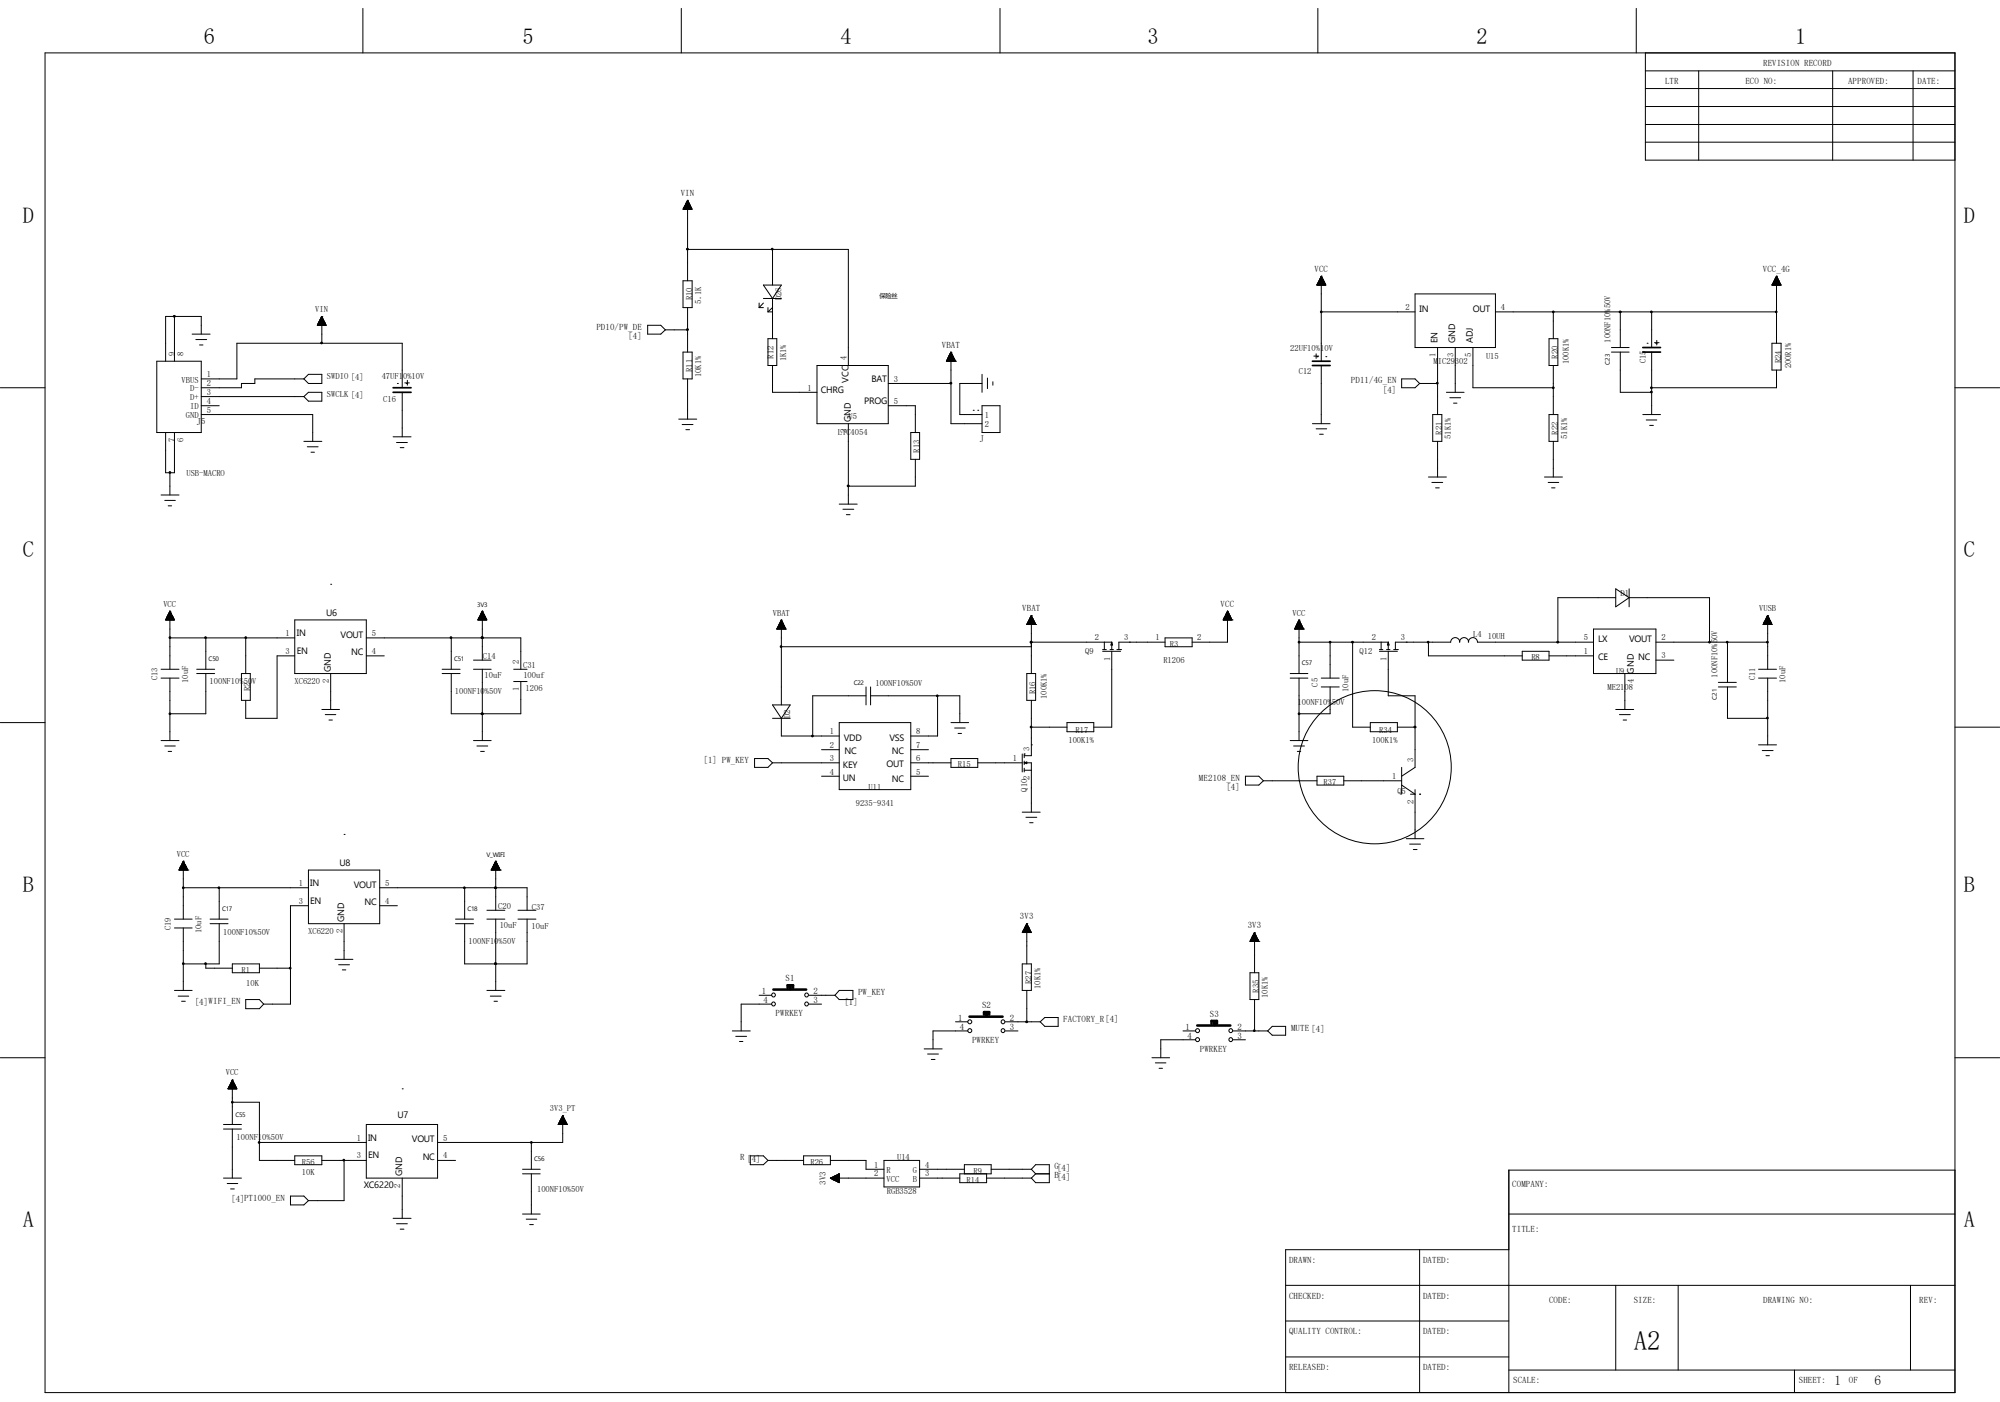
[picture p24: page 1]

VIN | REVISION RECORD

LTR | ECO NO: | APPROVED: | DATE:

DRAWN: | DATED:
CHECKED: | DATED: | CODE: | SIZE: A2 | DRAWING NO: | REV:

QUALITY CONTROL: | DATED:

RELEASED: | DATED:

SCALE: | SHEET: 1 6 OF

D

D

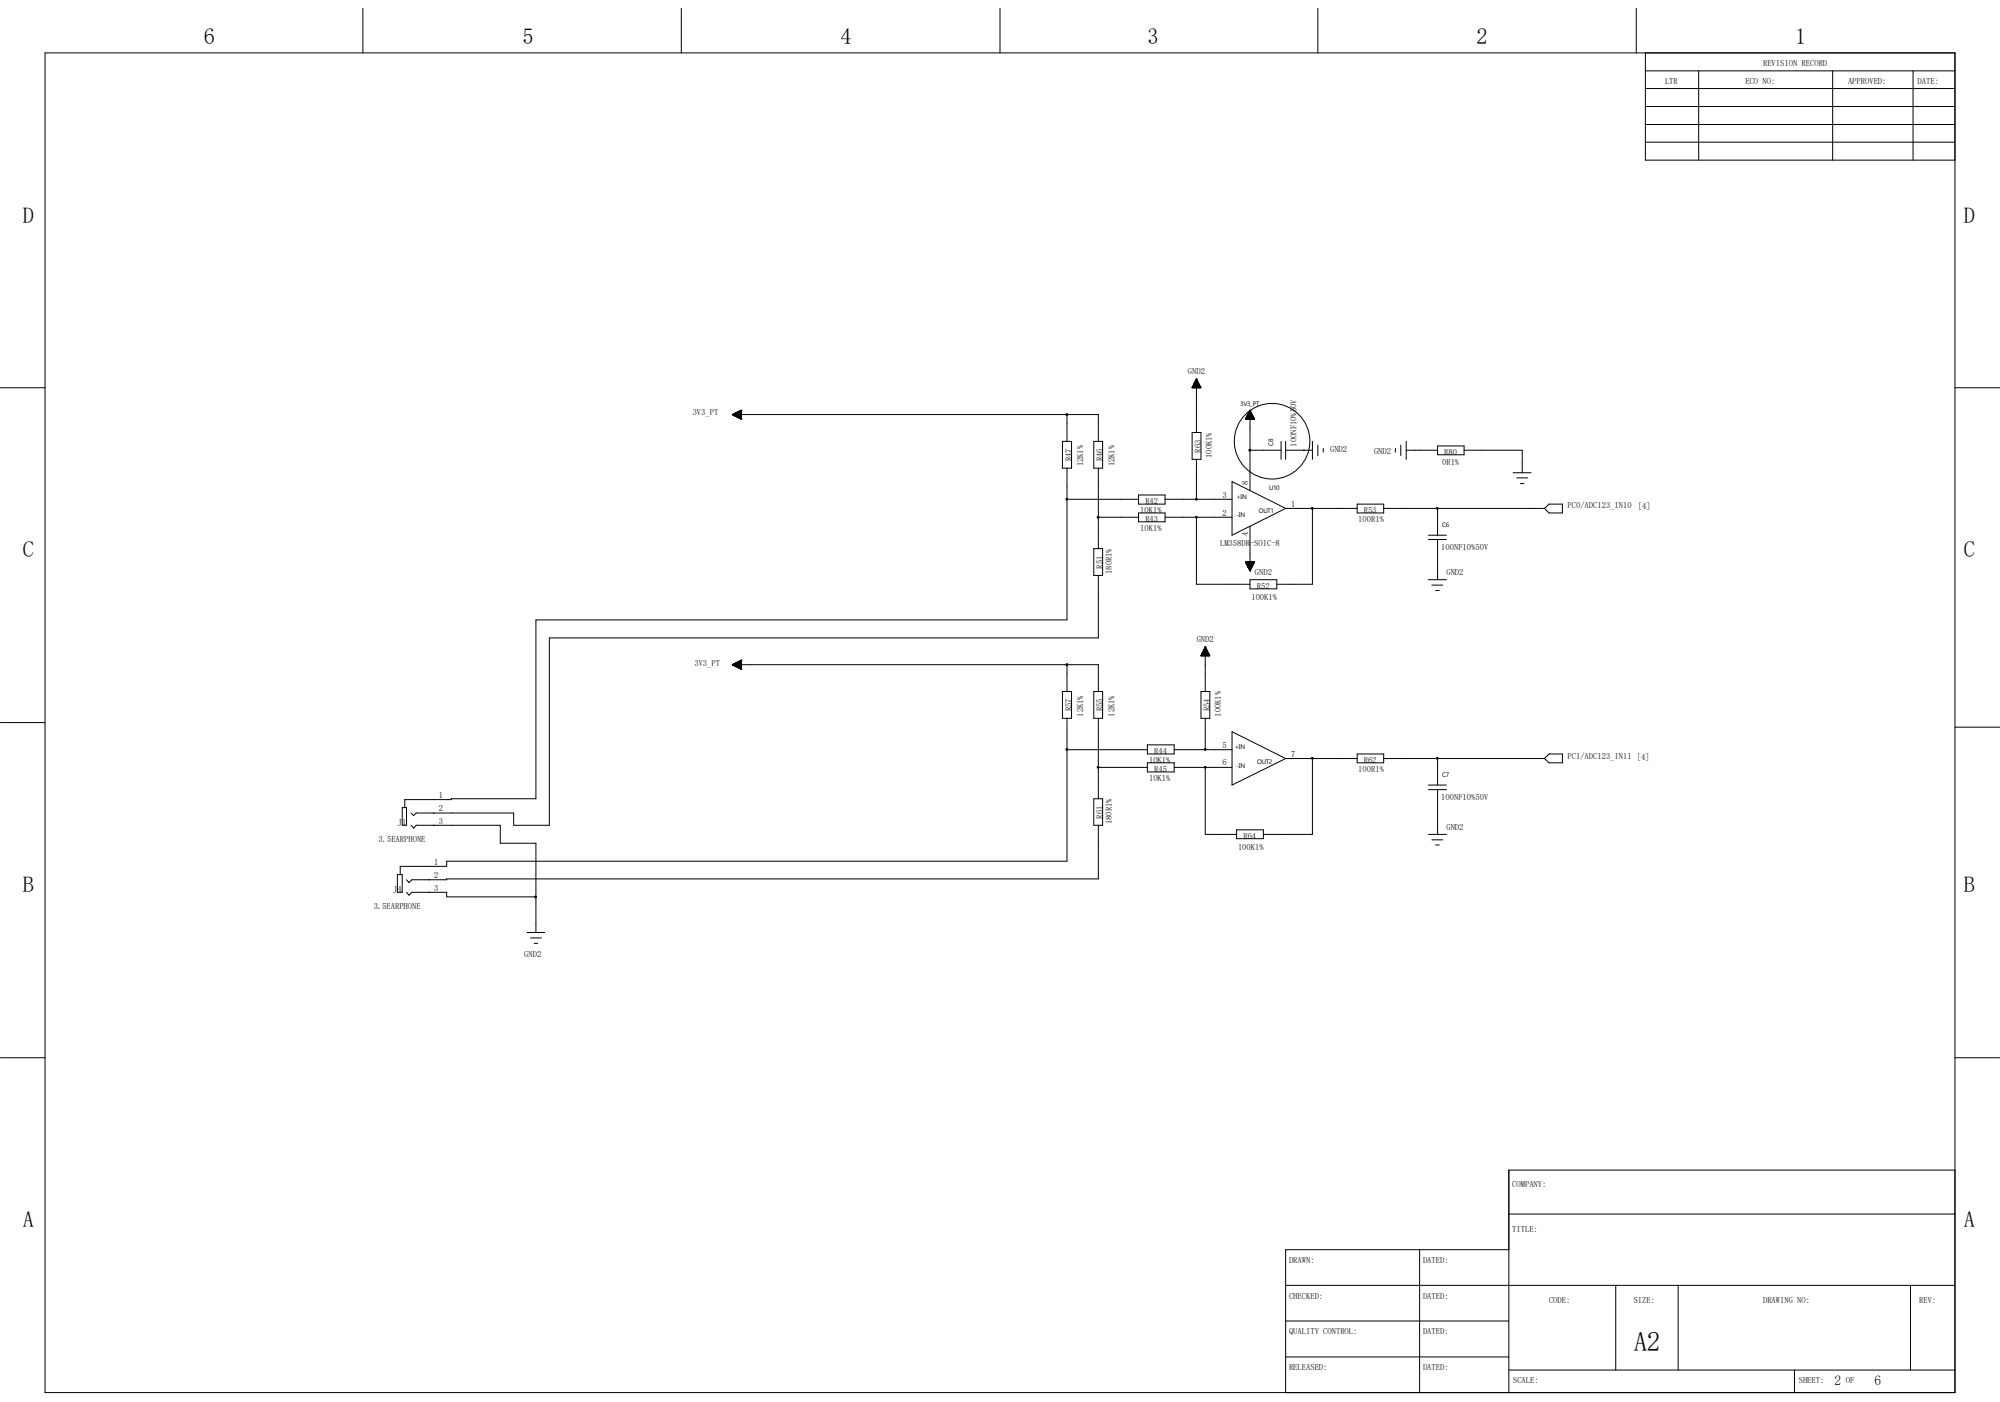
[picture p25: page 2]

D

D

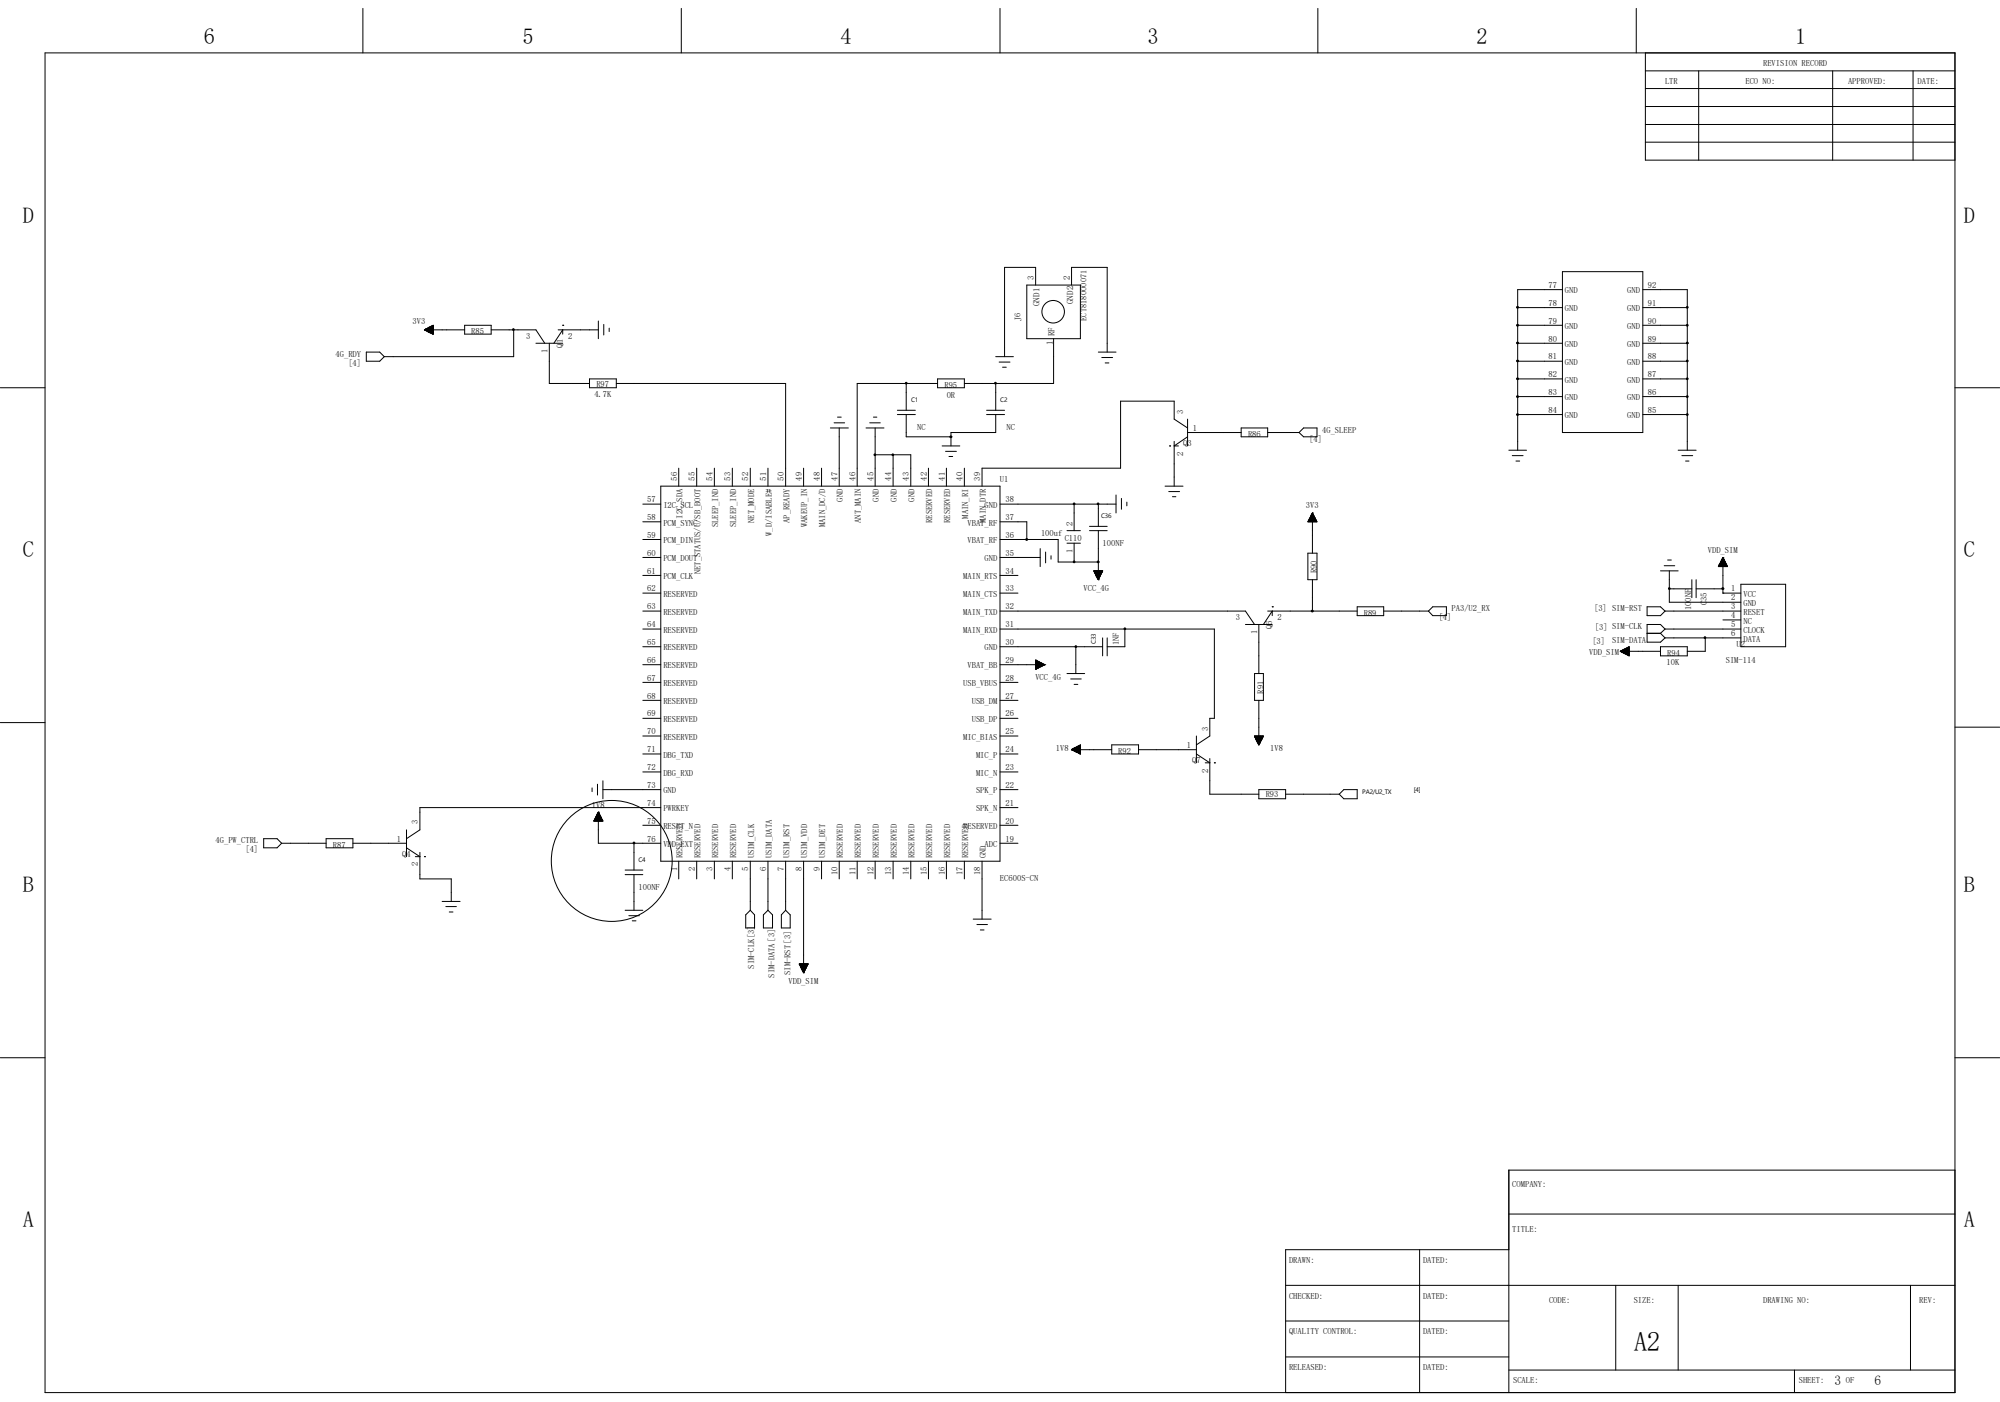
[picture p26: page 3]

78 GND | 91 GND

79 GND | 90 GND

80 GND | 89 GND

81 GND | 88 GND

82 GND | 87 GND

83 GND | 86 GND

D

D

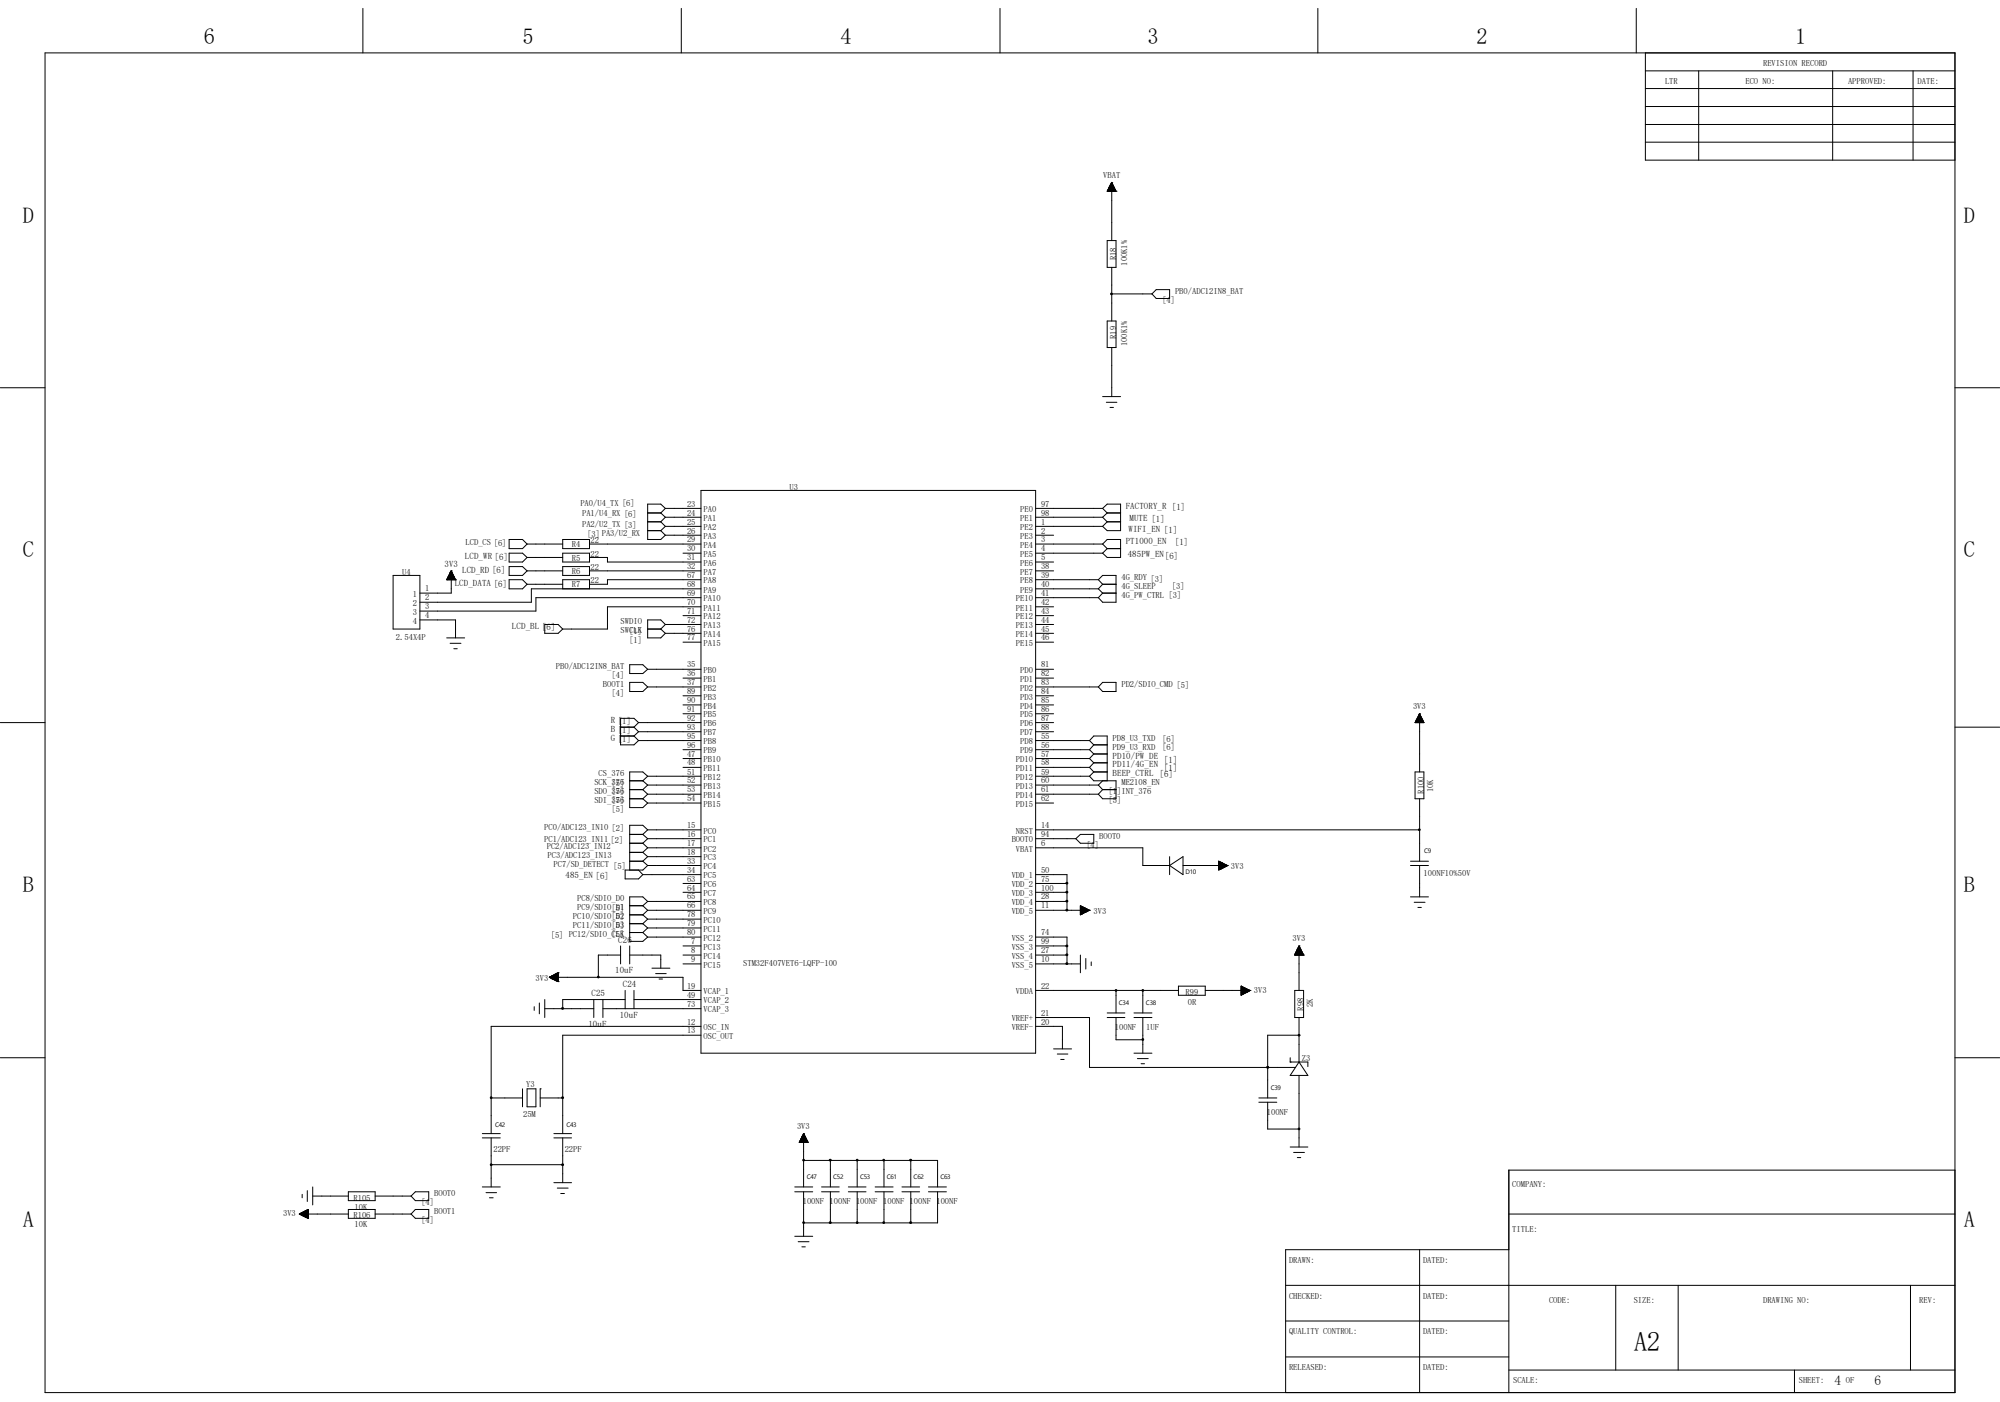
[picture p27: page 4]

D

D

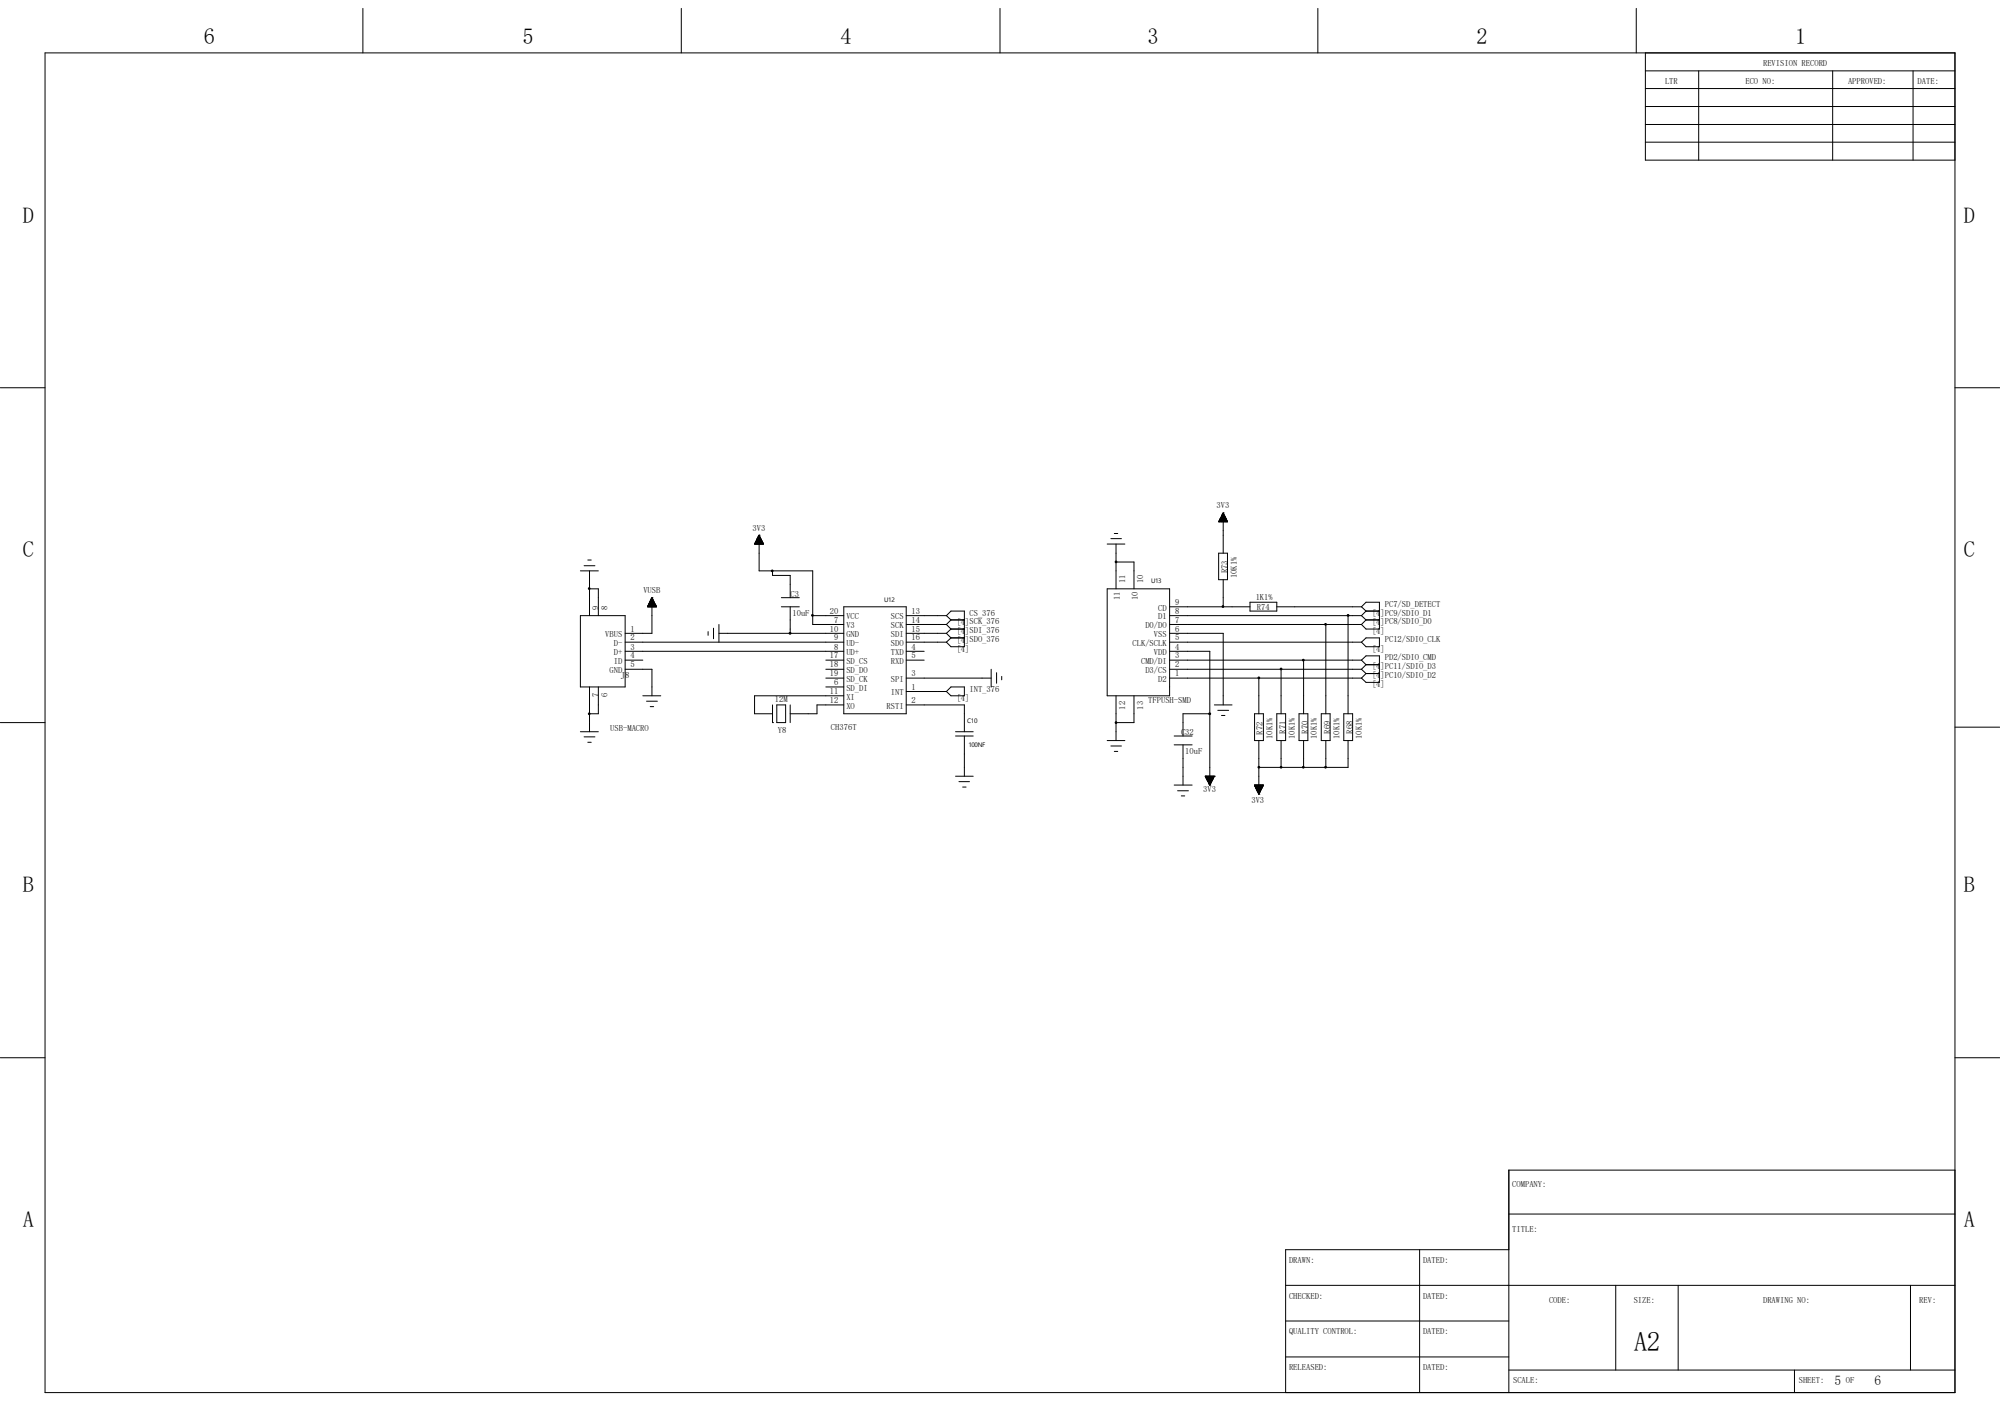
[picture p28: page 5]

D

D

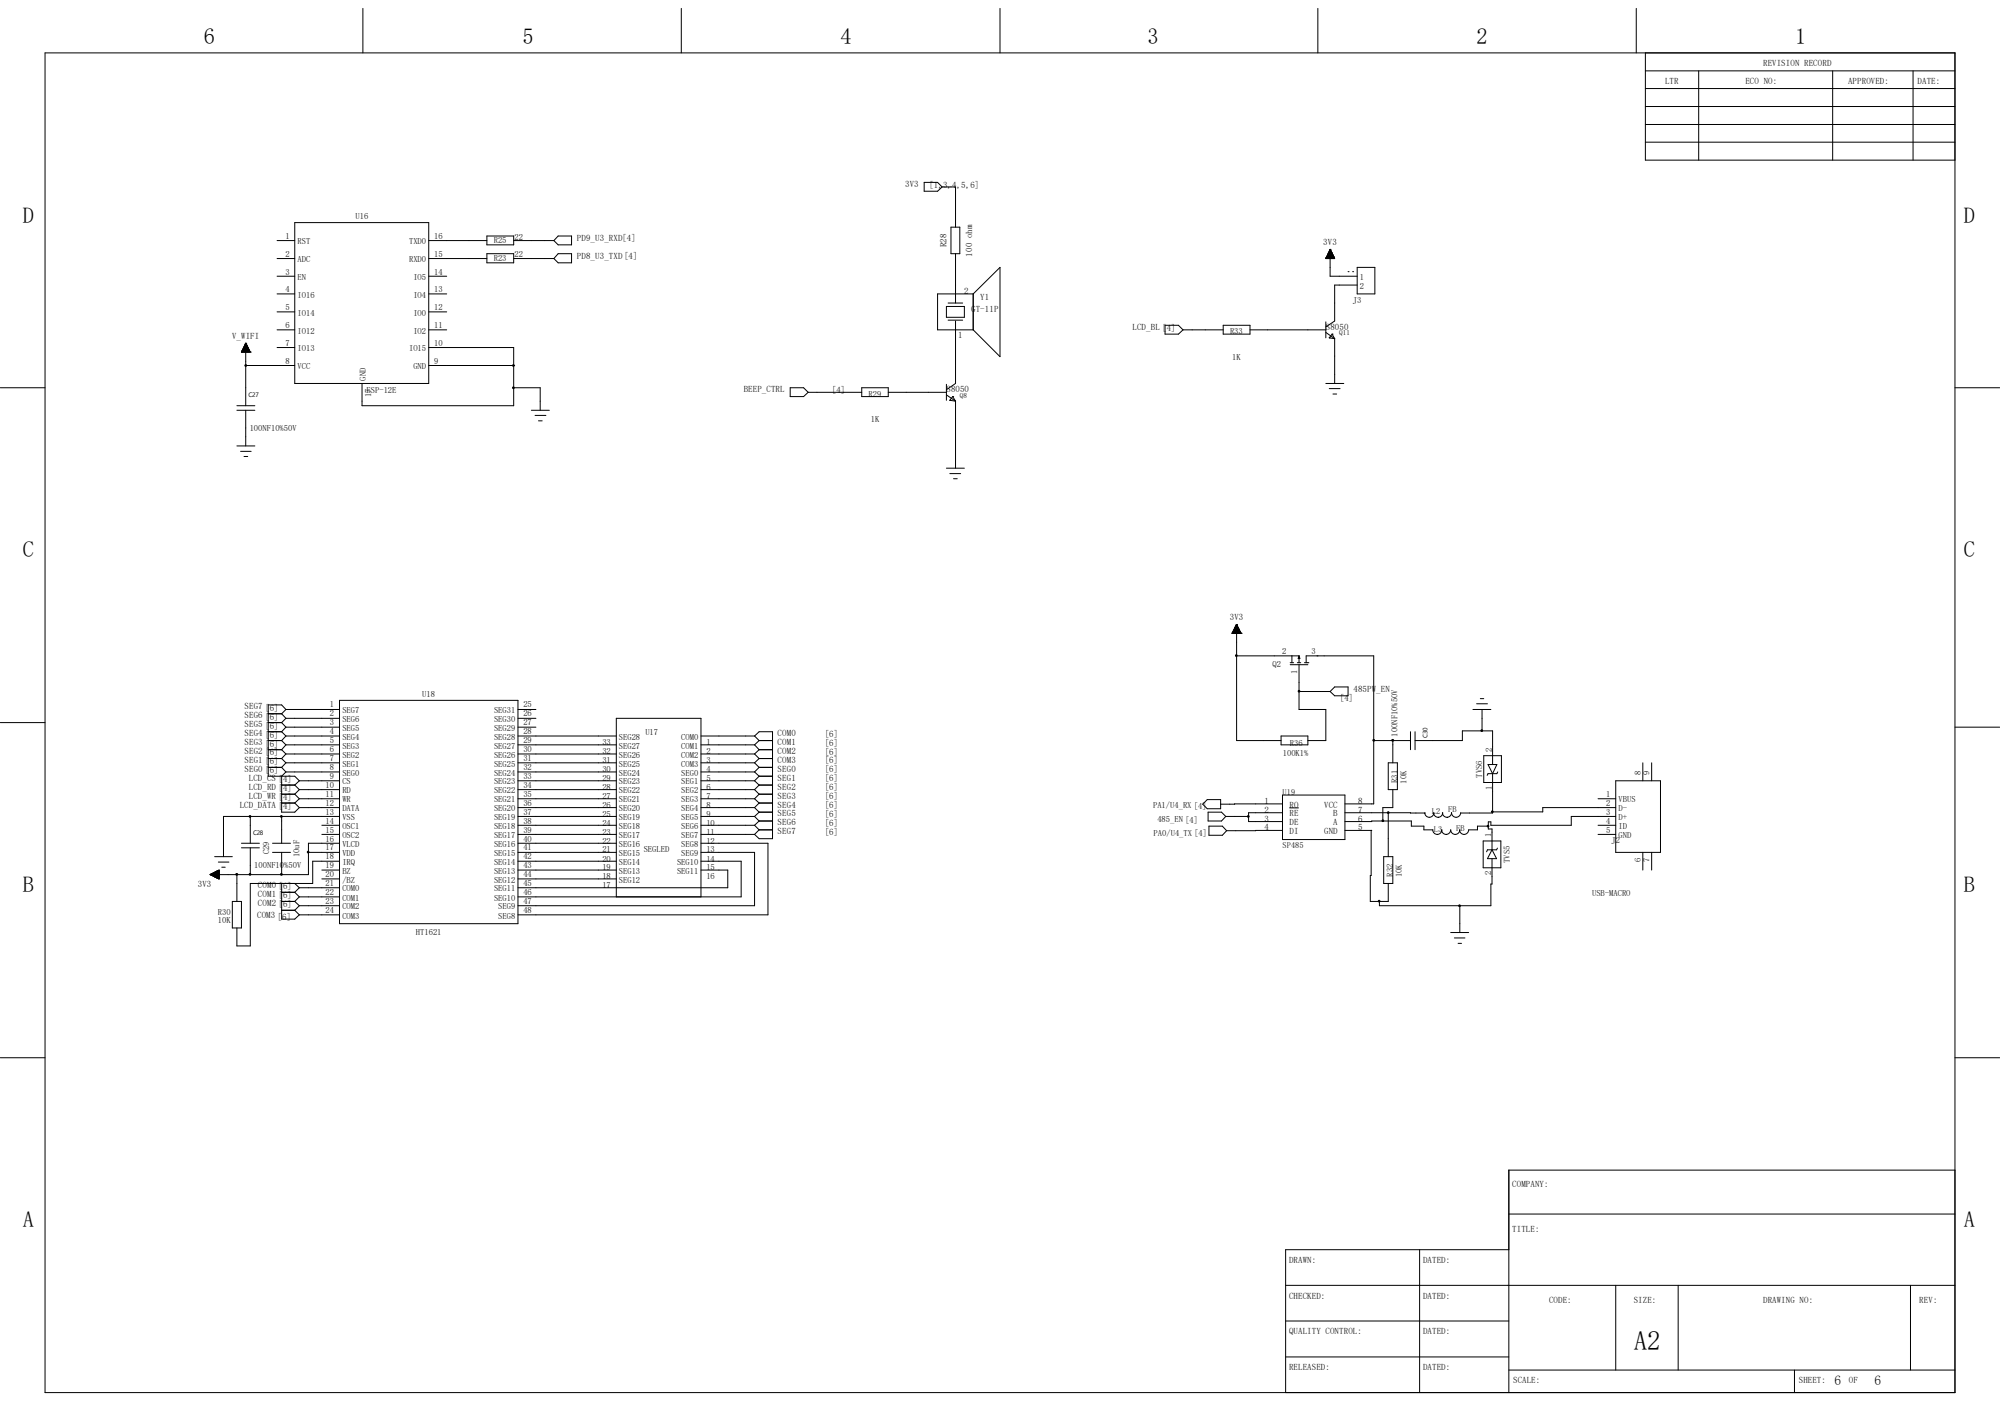
[picture p29: page 6]

25 SEG31 26 SEG30 27 SEG29 28 SEG28 29 SEG27 30 SEG26 31 SEG25 32 SEG24 33 SEG23 34 SEG22 35 SEG21 36 SEG20 37 SEG19 38 SEG18 39 SEG17 40 SEG16 41 SEG15 42 SEG14 43 SEG13 44 SEG12 45 SEG11 46 SEG10 47 SEG9 48 SEG8 | 5

SEG3 6 | | 2
SEG2 7 | | 3
SEG1 8 SEG0 9 | | 4
