CrazyHao1514/osd/3-1-OSD_I_V3 PCB图纸/1-2-OSD_Ⅰ_V3PCB图纸.pdf

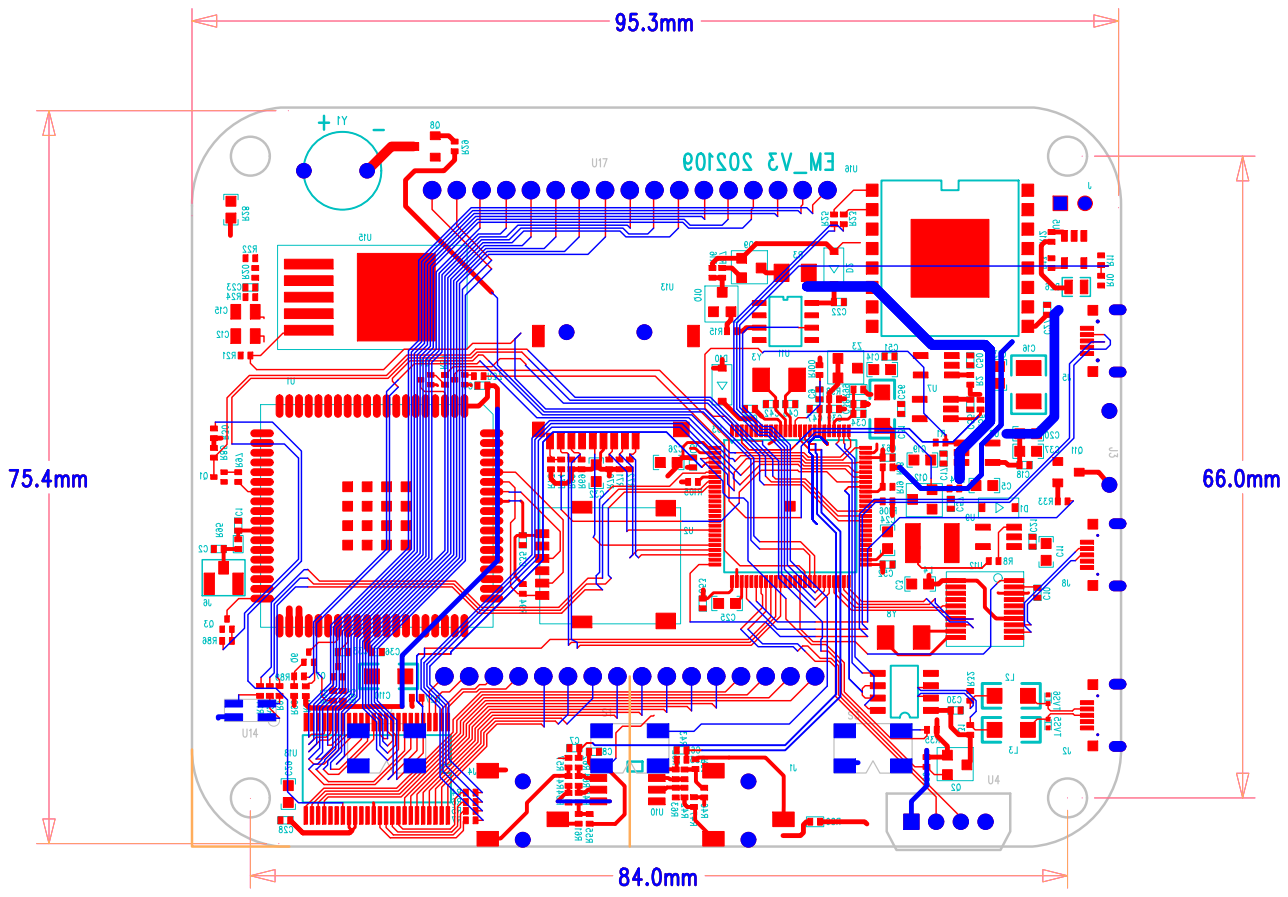
[picture p30: page 1]
