CrazyHao1514/osd/(list of files, drawings)

Other design files:
3-1-OSD_I_V3 PCB图纸/1-2-OSD_Ⅰ_V3PCB设计图纸4.pcb
3-1-OSD_I_V3 PCB图纸/1-2-OSD_Ⅰ_V3PCB设计图纸.pcb
